vkorehov/LEAKCAM/BOM_LCSC.txt

LCSC order list, 2 board(s), generated from the schematic Descriptions; prices JLCPCB/LCSC parts API

qty   LCSC#       Basic/Ext value                        link                                               MPN  (designators)

2     C2757850    Extended  AHT20                        https://www.lcsc.com/product-detail/C2757850.html  AHT20  (U17)
2     C41368035   Extended  ai-m62-cbs(blifn4)           https://www.lcsc.com/product-detail/C41368035.html Ai-M62-CBS(BLIFN4)  (U11)
4     C28323      Basic     1uF 0805                     https://www.lcsc.com/product-detail/C28323.html    CL21B105KBFNNNE  (C97 C101)
108   C2903663    Extended  100n 0201                    https://www.lcsc.com/product-detail/C2903663.html  TCC0201X5R104K160ZT  (C10 C12 C13 C25 C26 C27 C28 C29 C30 C31 C37 C39 C40 C42 C43 C44 C45 C46 C47 C48 C49 C51 C52 C53 C54 C55 C56 C57 C58 C63 C65 C66 C67 C68 C69 C70 C71 C72 C73 C74 C75 C76 C77 C78 C79 C80 C81 C82 C84 C85 C93 C94 C100 CB2)
24    C307331     Basic     100n                         https://www.lcsc.com/product-detail/C307331.html   CL05B104KB54PNC  (C5 C6 C7 C8 C9 C23 C24 C32 C88 C92 C95 C109)
4     C1546       Basic     100pf                        https://www.lcsc.com/product-detail/C1546.html     0402CG101J500NT  (C21 C22)
4     C1547       Basic     12p                          https://www.lcsc.com/product-detail/C1547.html     0402CG120J500NT  (C35 C36)
10    C1554       Basic     20p                          https://www.lcsc.com/product-detail/C1554.html     0402CG200J500NT  (C33 C34 C98 C111 C112)
4     C16772      Basic     220n                         https://www.lcsc.com/product-detail/C16772.html    CL05B224KO5NNNC  (C103 C107)
6     C22466352   Promo     DSK24                        https://www.lcsc.com/product-detail/C22466352.html DSK24  (D2 D7 D8)
4     C22459552   Extended  05b20l22p                    https://www.lcsc.com/product-detail/C22459552.html 05B20L22P  (J4 J5)
4     C1848       Basic     1uF 50V 1206                 https://www.lcsc.com/product-detail/C1848.html     CL31B105KBHNNNE  (C1 C104)
4     C32346      Basic     Q13FC13500004                https://www.lcsc.com/product-detail/C32346.html    Q13FC13500004  (Y1 Y3)
8     C14709      Basic     BLM18PG121SN1D               https://www.lcsc.com/product-detail/C14709.html    BLM18PG121SN1D  (FB1 FB2 FB3 FB4)
10    C668312     Extended  DFE201612E-R47M=P2           https://www.lcsc.com/product-detail/C668312.html   DFE201612E-R47M=P2  (L1 L2 L3 L4 L5)
4     C703141     Extended  DFE252012F-100M=P2           https://www.lcsc.com/product-detail/C703141.html   DFE252012F-100M=P2  (L6 L7)
6     C2845237    Extended  TPS63802DLAR                 https://www.lcsc.com/product-detail/C2845237.html  TPS63802DLAR  (U5 U8 U10)
4     C2693497    Extended  TPS62823DLCR                 https://www.lcsc.com/product-detail/C2693497.html  TPS62823DLCR  (U6 U7)
30    C19702      Basic     10uF GRM188R61A106ME69D      https://www.lcsc.com/product-detail/C19702.html    CL10A106KP8NNNC  (C2 C3 C4 C11 C15 C16 C19 C50 C90 C96 C99 C102 C105 C106 CB1)
2     C15849      Basic     1uF 0603                     https://www.lcsc.com/product-detail/C15849.html    CL10A105KB8NNNC  (C86)
12    C59461      Basic     22uF GRM188R60J226MEA0J      https://www.lcsc.com/product-detail/C59461.html    CL10A226MQ8NRNC  (C14 C17 C18 C20 C87 C89)
2     C2286       Basic     KT-0603R                     https://www.lcsc.com/product-detail/C2286.html     KT-0603R  (D1)
2     C15127      Basic     AO3401A                      https://www.lcsc.com/product-detail/C15127.html    AO3401A  (Q1)
4     C20917      Basic     AO3400A                      https://www.lcsc.com/product-detail/C20917.html    AO3400A  (Q2 Q4)
6     C478118     Extended  PRTR5V0U2F,115               https://www.lcsc.com/product-detail/C478118.html   PRTR5V0U2F,115  (D3 D4 D5)
2     C22769      Extended  1.5R                         https://www.lcsc.com/product-detail/C22769.html    0603WAF150KT5E  (R68)
2     C23157      Extended  3R                           https://www.lcsc.com/product-detail/C23157.html    0603WAF300KT5E  (R66)
2     C2965580    Extended  XL7EL89CKI-111YLC-24M        https://www.lcsc.com/product-detail/C2965580.html  XL7EL89CKI-111YLC-24M  (Y2)
16    C19185834   Extended  jnj-ltji0112w120/35mil/845-8 https://www.lcsc.com/product-detail/C19185834.html JNJ-LTJI0112W120/35mil/845-860nm  (LED3 LED6 LED7 LED10 LED11 LED14 LED15 LED16)
6     C157932     Extended  S2B-PH-K-S(LF)(SN)           https://www.lcsc.com/product-detail/C157932.html   S2B-PH-K-S-GW  (S1 S2 S3)
2     C42414902   Extended  k230d                        https://www.lcsc.com/product-detail/C42414902.html K230D  (U3)
8     C25867      Basic     1.5k                         https://www.lcsc.com/product-detail/C25867.html    0402WGF1501TCE  (R5 R12 RD1 RD2)
40    C25741      Basic     100k                         https://www.lcsc.com/product-detail/C25741.html    0402WGF1003TCE  (R6 R8 R19 R20 R23 R26 R27 R28 R30 R32 R35 R38 R45 R49 R51 R53 R58 R60 R61 R76)
38    C25744      Basic     10k                          https://www.lcsc.com/product-detail/C25744.html    0402WGF1002TCE  (R2 R3 R10 R13 R16 R31 R34 R36 R39 R40 R41 R43 R44 R57 R64 R65 R67 R70 RBT1)
2     C25750      Promo     120k                         https://www.lcsc.com/product-detail/C25750.html    0402WGF1203TCE  (R29)
4     C26083      Basic     1M                           https://www.lcsc.com/product-detail/C26083.html    0402WGF1004TCE  (R71 R72)
2     C11702      Basic     1k                           https://www.lcsc.com/product-detail/C11702.html    0402WGF1001TCE  (R7)
4     C25087      Basic     200R                         https://www.lcsc.com/product-detail/C25087.html    0402WGF2000TCE  (R37 R62)
2     C25764      Basic     200k                         https://www.lcsc.com/product-detail/C25764.html    0402WGF2003TCE  (R59)
2     C25765      Basic     20k                          https://www.lcsc.com/product-detail/C25765.html    0402WGF2002TCE  (R69)
4     C25092      Basic     22R                          https://www.lcsc.com/product-detail/C25092.html    0402WGF220JTCE  (R42 R54)
10    C324768     Extended  240R                         https://www.lcsc.com/product-detail/C324768.html   RC-02K2400FT  (R33 R46 R47 R48 R52)
2     C49653548   Extended  30k                          https://www.lcsc.com/product-detail/C49653548.html GR0402F30KTAG00  (R63)
2     C25779      Basic     33k                          https://www.lcsc.com/product-detail/C25779.html    0402WGF3302TCE  (R25)
12    C25900      Basic     4.7k                         https://www.lcsc.com/product-detail/C25900.html    0402WGF4701TCE  (R14 R15 R17 R18 R73 R74)
14    C25792      Basic     47k                          https://www.lcsc.com/product-detail/C25792.html    0402WGF4702TCE  (R21 RB1 RB2 RB3 RB4 RB5 RB6)
8     C25905      Basic     5.1k                         https://www.lcsc.com/product-detail/C25905.html    0402WGF5101TCE  (R1 R4 R9 R11)
4     C49655223   Extended  511k                         https://www.lcsc.com/product-detail/C49655223.html GR0402F511KTAG00  (R22 R50)
2     C25794      Basic     51k                          https://www.lcsc.com/product-detail/C25794.html    0402WGF5102TCE  (R56)
4     C54920709   Extended  91k                          https://www.lcsc.com/product-detail/C54920709.html HRC0402F9102DNTO  (R24 R55)
2     C129319     Extended  BQ24072TRGTR                 https://www.lcsc.com/product-detail/C129319.html   BQ24072TRGTR  (U1)
4     C324075     Extended  TPS61161DRVR                 https://www.lcsc.com/product-detail/C324075.html   TPS61161DRVR  (U14 U15)
4     C165948     Extended  type-c-31-m-12               https://www.lcsc.com/product-detail/C165948.html   TYPE-C-31-M-12  (USBC1 USBC2)
16    C3646951    Extended  xl-hd3535uwc-a2              https://www.lcsc.com/product-detail/C3646951.html  XL-HD3535UWC-A2  (LED1 LED2 LED4 LED5 LED8 LED9 LED12 LED13)
2     C3035748    Extended  ch340x                       https://www.lcsc.com/product-detail/C3035748.html  CH340X  (U2)
2     C51928208   Extended  msm381acb026                 https://www.lcsc.com/product-detail/C51928208.html MSM381ACB026  (U13)
2     C17626844   Extended  w25n02kvzeir                 https://www.lcsc.com/product-detail/C17626844.html W25N02KVZEIR  (U16)

NO PART: ANT1 MIFI, B1_N TESTP, B1_P TESTP, CT1 NF, J1 Connector 2PIn, J2 Connector 2PIn, J3 Connector 2PIn, J6 Connector 2PIn, J7 Connector 2PIn, J8 Connector 2PIn, J9 Connector 2PIn, J10 Connector 2PIn, J11 Connector 2PIn, J12 Connector 2PIn, JB1 Connector 2PIn, JB2 Connector 2PIn, JT Connector 2PIn, PR1 CON6P

TOTAL 94.48 USD
