vkorehov/LEAKCAM/BOM_NEXTPCB.xlsx

Designator* | Quantity* | Manufacturer Part Number* | Manufacturer | Package/Footprint | Description | Procurement Type | Customer Note
U17 | 1 | AHT20 | Aosong (Guangzhou) Elec | SMD | -40℃~+120℃ 0%RH~100%RH 2.2V~5.5V 20bit 570uA I2C ±0.3℃ ±2%RH SMD Temperature and Humidity Sensor ROHS |  | LCSC C2757850, AHT20
U11 | 1 | Ai-M62-CBS(BLIFN4) | Ai-Thinker | SMD,12x12mm | -40℃~+85℃ -98dBm 2.97V~3.6V 22dBm 394mA 59mA BL616 UART、SDIO、SPI、I2C、GPIO、PWM、I2S、USB2.0 SMD,12x12mm WiFi Modules ROHS |  | LCSC C41368035, ai-m62-cbs(blifn4)
C97,C101 | 2 | CL21B105KBFNNNE | Samsung Electro-Mechanics | 0805 | 1uF 50V X7R ±10% 0805 Multilayer Ceramic Capacitors MLCC - SMD/SMT ROHS |  | LCSC C28323, 1uF 0805
C10,C12,C13,C25,C26,C27,C28,C29,C30,C31,C37,C39,C40,C42,C43,C44,C45,C46,C47,C48,C49,C51,C52,C53,C54,C55,C56,C57,C58,C63,C65,C66,C67,C68,C69,C70,C71,C72,C73,C74,C75,C76,C77,C78,C79,C80,C81,C82,C84,C85,C93,C94,C100,CB2 | 54 | TCC0201X5R104K160ZT | CCTC | 0201 | 100nF 16V X5R ±10% 0201 Multilayer Ceramic Capacitors MLCC - SMD/SMT ROHS |  | LCSC C2903663, 100n 0201
C5,C6,C7,C8,C9,C23,C24,C32,C88,C92,C95,C109 | 12 | CL05B104KB54PNC | Samsung Electro-Mechanics | 0402 | 100nF 50V X7R ±10% 0402 Multilayer Ceramic Capacitors MLCC - SMD/SMT ROHS |  | LCSC C307331, 100n
C21,C22 | 2 | 0402CG101J500NT | FH (Guangdong Fenghua Advanced Tech) | 0402 | 100pF 50V C0G ±5% 0402 Multilayer Ceramic Capacitors MLCC - SMD/SMT ROHS |  | LCSC C1546, 100pf
C35,C36 | 2 | 0402CG120J500NT | FH (Guangdong Fenghua Advanced Tech) | 0402 | 12pF 50V C0G ±5% 0402 Multilayer Ceramic Capacitors MLCC - SMD/SMT ROHS |  | LCSC C1547, 12p
C33,C34,C98,C111,C112 | 5 | 0402CG200J500NT | FH (Guangdong Fenghua Advanced Tech) | 0402 | 20pF 50V C0G ±5% 0402 Multilayer Ceramic Capacitors MLCC - SMD/SMT ROHS |  | LCSC C1554, 20p
C103,C107 | 2 | CL05B224KO5NNNC | Samsung Electro-Mechanics | 0402 | 16V 220nF X7R ±10% 0402 Multilayer Ceramic Capacitors MLCC - SMD/SMT ROHS |  | LCSC C16772, 220n
D2,D7,D8 | 3 | DSK24 | hongjiacheng | SOD-123FL | -55℃~+125℃ 2A 40V 500uA@40V 50A 550mV@2A Standalone SOD-123FL Schottky Diodes ROHS |  | LCSC C22466352, DSK24
J4,J5 | 2 | 05B20L22P | HanElectricity | SMD,P=0.5mm,Surface Mount，Right Angle | -25℃~+85℃ 0.3mm 0.5mm 22P 2mm 400mA 50V Bottom Contact Phosphor bronze Slide Lock Surface Mount, Right Angle Tin SMD,P=0 |  | LCSC C22459552, 05b20l22p
C1,C104 | 2 | CL31B105KBHNNNE | Samsung Electro-Mechanics | 1206 | 1uF 50V X7R ±10% 1206 Multilayer Ceramic Capacitors MLCC - SMD/SMT ROHS |  | LCSC C1848, 1uF 50V 1206
Y1,Y3 | 2 | Q13FC13500004 | Seiko Epson | SMD3215-2P | -40℃~+85℃ 12.5pF 32.768kHz 70kΩ Crystal Oscillator ±20ppm SMD3215-2P Crystals ROHS |  | LCSC C32346, Q13FC13500004
FB1,FB2,FB3,FB4 | 4 | BLM18PG121SN1D | Murata Electronics | 0603 | -55℃~+125℃ 1 120Ω@100MHz 2A 50mΩ ±25% 0603 Ferrite Beads ROHS |  | LCSC C14709, BLM18PG121SN1D
L1,L2,L3,L4,L5 | 5 | DFE201612E-R47M=P2 | Murata Electronics | 0806 | 26mΩ 4.5A 470nH 5.5A ±20% 0806 Power Inductors ROHS |  | LCSC C668312, DFE201612E-R47M=P2
L6,L7 | 2 | DFE252012F-100M=P2 | Murata Electronics | 1008 | 1.4A 10uH 400mΩ 950mA ±20% 1008 Power Inductors ROHS |  | LCSC C703141, DFE252012F-100M=P2
U5,U8,U10 | 3 | TPS63802DLAR | Texas Instruments | VSON-10(2x3) | -40℃~+125℃@(TJ) 1 1.3V~5.5V 1.4MHz、1.6MHz、2.1MHz 1.8V~5.2V 11uA 2A Adjustable Buck-Boost Buck-Boost Built-in Yes VSON-10 |  | LCSC C2845237, TPS63802DLAR
U6,U7 | 2 | TPS62823DLCR | Texas Instruments | VSON-8(1.5x2) | -40℃~+125℃@(TJ) 1 2.2MHz 2.4V~5.5V 3A 4uA 600mV~4V Adjustable Buck Built-in Overcurrent Protection、Light load efficient |  | LCSC C2693497, TPS62823DLCR
C2,C3,C4,C11,C15,C16,C19,C38,C41,C50,C59,C90,C96,C99,C102,C105,C106,CB1 | 18 | CL10A106KP8NNNC | Samsung Electro-Mechanics | 0603 | 10V 10uF X5R ±10% 0603 Multilayer Ceramic Capacitors MLCC - SMD/SMT ROHS |  | LCSC C19702, 10uF GRM188R61A106ME69D
C86 | 1 | CL10A105KB8NNNC | Samsung Electro-Mechanics | 0603 | 1uF 50V X5R ±10% 0603 Multilayer Ceramic Capacitors MLCC - SMD/SMT ROHS |  | LCSC C15849, 1uF 0603
C14,C17,C18,C20,C87,C89 | 6 | CL10A226MQ8NRNC | Samsung Electro-Mechanics | 0603 | 22uF 6.3V X5R ±20% 0603 Multilayer Ceramic Capacitors MLCC - SMD/SMT ROHS |  | LCSC C59461, 22uF GRM188R60J226MEA0J
D1 | 1 | KT-0603R | Hubei KENTO Elec | 0603 | -40℃~+85℃ 1.6mm x 0.8mm square LED 1.8V~2.4V 120° 20mA 300mcd 40mW 615nm~630nm 645nm Discrete Diode Red Water Clear 0603 |  | LCSC C2286, KT-0603R
Q1 | 1 | AO3401A | Alpha & Omega Semicon | SOT-23 | 1 P-Channel 14nC@10V 30V 47mΩ@10V、60mΩ@4.5V、85mΩ@2.5V 4A 55pF 645pF 80pF 900mV SOT-23 MOSFETs ROHS |  | LCSC C15127, AO3401A
Q2,Q4 | 2 | AO3400A | Alpha & Omega Semicon | SOT-23 | -55℃~+150℃ 1 N-channel 1.45V 1.4W 30V 48mΩ@2.5V 5.7A 50pF 630pF 75pF 7nC@10V N-Channel SOT-23 MOSFETs ROHS |  | LCSC C20917, AO3400A
D3,D4,D5 | 3 | PRTR5V0U2F,115 | Nexperia | XSON-6(1x1.5) | -40℃~+85℃ 100nA 1pF 2 5.5V 6V IEC 61000-4-2 TVS Unidirectional XSON-6(1x1.5) ESD and Surge Protection (TVS/ESD) ROHS |  | LCSC C478118, PRTR5V0U2F,115
R68 | 1 | 0603WAF150KT5E | UNI-ROYAL(Uniroyal Elec) | 0603 | -55℃~+155℃ 1.5Ω 100mW 75V Thick Film Resistor ±1% ±200ppm/℃ 0603 Chip Resistor - Surface Mount ROHS |  | LCSC C22769, 1.5R
R66 | 1 | 0603WAF300KT5E | UNI-ROYAL(Uniroyal Elec) | 0603 | -55℃~+155℃ 100mW 3Ω 75V Thick Film Resistor ±1% ±200ppm/℃ 0603 Chip Resistor - Surface Mount ROHS |  | LCSC C23157, 3R
Y2 | 1 | XL7EL89CKI-111YLC-24M | YXC Crystal Oscillators | SMD2016-4P | -40℃~+85℃ 100Ω 24MHz 8pF Crystal Oscillator ±10ppm ±20ppm SMD2016-4P Crystals ROHS |  | LCSC C2965580, XL7EL89CKI-111YLC-24M
LED3,LED6,LED7,LED10,LED11,LED14,LED15,LED16 | 8 | JNJ-LTJI0112W120/35mil/845-860nm | JNJ OPTOELECTRONICS | SMD3535-3P | -40℃~+100℃ 1.4V~2.1V、1.5V~2.3V 120° 1A 50nm 5V 75mW/sr@IF=350mA、140mW/sr@IF=1000mA 850nm SMD3535-3P Infrared LED Emitter |  | LCSC C19185834, jnj-ltji0112w120/35mil/845-860nm
U3 | 1 | K230D | Canaan | BGA-256 | BGA-256 Microcontrollers (MCU/MPU/SOC) ROHS |  | LCSC C42414902, k230d
R5,R12,RD1,RD2 | 4 | 0402WGF1501TCE | UNI-ROYAL(Uniroyal Elec) | 0402 | -55℃~+155℃ 1.5kΩ 50V 62.5mW Thick Film Resistor ±1% ±100ppm/℃ 0402 Chip Resistor - Surface Mount ROHS |  | LCSC C25867, 1.5k
R6,R8,R19,R20,R23,R26,R27,R28,R30,R32,R35,R38,R45,R49,R51,R53,R58,R60,R61,R76 | 20 | 0402WGF1003TCE | UNI-ROYAL(Uniroyal Elec) | 0402 | -55℃~+155℃ 100kΩ 50V 62.5mW Thick Film Resistor ±1% ±100ppm/℃ 0402 Chip Resistor - Surface Mount ROHS |  | LCSC C25741, 100k
R2,R3,R10,R13,R16,R31,R34,R36,R39,R40,R41,R43,R44,R57,R64,R65,R67,R70,RBT1 | 19 | 0402WGF1002TCE | UNI-ROYAL(Uniroyal Elec) | 0402 | -55℃~+155℃ 10kΩ 50V 62.5mW Thick Film Resistor ±1% ±100ppm/℃ 0402 Chip Resistor - Surface Mount ROHS |  | LCSC C25744, 10k
R29 | 1 | 0402WGF1203TCE | UNI-ROYAL(Uniroyal Elec) | 0402 | -55℃~+155℃ 120kΩ 50V 62.5mW Thick Film Resistor ±1% ±100ppm/℃ 0402 Chip Resistor - Surface Mount ROHS |  | LCSC C25750, 120k
R71,R72 | 2 | 0402WGF1004TCE | UNI-ROYAL(Uniroyal Elec) | 0402 | -55℃~+155℃ 1MΩ 50V 62.5mW Thick Film Resistor ±1% ±100ppm/℃ 0402 Chip Resistor - Surface Mount ROHS |  | LCSC C26083, 1M
R7 | 1 | 0402WGF1001TCE | UNI-ROYAL(Uniroyal Elec) | 0402 | -55℃~+155℃ 1kΩ 50V 62.5mW Thick Film Resistor ±1% ±100ppm/℃ 0402 Chip Resistor - Surface Mount ROHS |  | LCSC C11702, 1k
R37,R62 | 2 | 0402WGF2000TCE | UNI-ROYAL(Uniroyal Elec) | 0402 | -55℃~+155℃ 200Ω 50V 62.5mW Thick Film Resistor ±1% ±100ppm/℃ 0402 Chip Resistor - Surface Mount ROHS |  | LCSC C25087, 200R
R59 | 1 | 0402WGF2003TCE | UNI-ROYAL(Uniroyal Elec) | 0402 | -55℃~+155℃ 200kΩ 50V 62.5mW Thick Film Resistor ±1% ±100ppm/℃ 0402 Chip Resistor - Surface Mount ROHS |  | LCSC C25764, 200k
R69 | 1 | 0402WGF2002TCE | UNI-ROYAL(Uniroyal Elec) | 0402 | -55℃~+155℃ 20kΩ 50V 62.5mW Thick Film Resistor ±1% ±100ppm/℃ 0402 Chip Resistor - Surface Mount ROHS |  | LCSC C25765, 20k
R42,R54 | 2 | 0402WGF220JTCE | UNI-ROYAL(Uniroyal Elec) | 0402 | -55℃~+155℃ 22Ω 50V 62.5mW Thick Film Resistor ±1% ±100ppm/℃ 0402 Chip Resistor - Surface Mount ROHS |  | LCSC C25092, 22R
R33,R46,R47,R48,R52 | 5 | RC-02K2400FT | FH (Guangdong Fenghua Advanced Tech) | 0402 | -55℃~+155℃ 240Ω 50V 62.5mW Thick Film Resistor ±1% ±100ppm/℃ 0402 Chip Resistor - Surface Mount ROHS |  | LCSC C324768, 240R
R63 | 1 | GR0402F30KTAG00 | GiantOhm | 0402 | -55℃~+155℃ 30kΩ 50V 62.5mW Thick Film Resistor ±1% ±100ppm/℃ 0402 Chip Resistor - Surface Mount ROHS |  | LCSC C49653548, 30k
R25 | 1 | 0402WGF3302TCE | UNI-ROYAL(Uniroyal Elec) | 0402 | -55℃~+155℃ 33kΩ 50V 62.5mW Thick Film Resistor ±1% ±100ppm/℃ 0402 Chip Resistor - Surface Mount ROHS |  | LCSC C25779, 33k
R14,R15,R17,R18,R73,R74 | 6 | 0402WGF4701TCE | UNI-ROYAL(Uniroyal Elec) | 0402 | -55℃~+155℃ 4.7kΩ 50V 62.5mW Thick Film Resistor ±1% ±100ppm/℃ 0402 Chip Resistor - Surface Mount ROHS |  | LCSC C25900, 4.7k
R21,RB1,RB2,RB3,RB4,RB5,RB6 | 7 | 0402WGF4702TCE | UNI-ROYAL(Uniroyal Elec) | 0402 | -55℃~+155℃ 47kΩ 50V 62.5mW Thick Film Resistor ±1% ±100ppm/℃ 0402 Chip Resistor - Surface Mount ROHS |  | LCSC C25792, 47k
R1,R4,R9,R11 | 4 | 0402WGF5101TCE | UNI-ROYAL(Uniroyal Elec) | 0402 | -55℃~+155℃ 5.1kΩ 50V 62.5mW Thick Film Resistor ±1% ±100ppm/℃ 0402 Chip Resistor - Surface Mount ROHS |  | LCSC C25905, 5.1k
R22,R50 | 2 | GR0402F511KTAG00 | GiantOhm | 0402 | -55℃~+155℃ 50V 511kΩ 62.5mW Thick Film Resistor ±1% 0402 Chip Resistor - Surface Mount ROHS |  | LCSC C49655223, 511k
R56 | 1 | 0402WGF5102TCE | UNI-ROYAL(Uniroyal Elec) | 0402 | -55℃~+155℃ 50V 51kΩ 62.5mW Thick Film Resistor ±1% ±100ppm/℃ 0402 Chip Resistor - Surface Mount ROHS |  | LCSC C25794, 51k
R24,R55 | 2 | HRC0402F9102DNTO | HWA CHN | 0402 | -55℃~+155℃ 50V 62.5mW 91kΩ Thick Film Resistor ±1% ±100ppm/℃ 0402 Chip Resistor - Surface Mount ROHS |  | LCSC C54920709, 91k
U1 | 1 | BQ24072TRGTR | Texas Instruments | QFN-16-EP(3x3) | 0℃~+125℃ 1.5A 1.5mA 4.2V 4.35V~6.4V Charging IC Lithium Battery Support QFN-16-EP(3x3) Battery Management ROHS |  | LCSC C129319, BQ24072TRGTR
U14,U15 | 2 | TPS61161DRVR | Texas Instruments | WSON-6-EP(2x2) | -40℃~+85℃ 1 2% 2.7V~18V 38V 600kHz Boost Built-in DC-DC Over Voltage Protection、Over-Temperature Protection (OTP) PWM WS |  | LCSC C324075, TPS61161DRVR
USBC1,USBC2 | 2 | TYPE-C-31-M-12 | Korean Hroparts Elec | SMD | -30℃~+80℃ 1 10,000 cycles 16P 20V 5A 7.35mm Female Surface Mount, Right Angle Type-C SMD USB Connectors ROHS |  | LCSC C165948, type-c-31-m-12
LED1,LED2,LED4,LED5,LED8,LED9,LED12,LED13 | 8 | XL-HD3535UWC-A2 | XINGLIGHT | SMD3535-3P | -40℃~+85℃ 130° 1W 2.8V~3.6V 350mA 5500K~7000K Discrete Diode Top-mount Water Clear White SMD3535-3P LED Indication - Dis |  | LCSC C3646951, xl-hd3535uwc-a2
U2 | 1 | CH340X | WCH(Jiangsu Qin Heng) | MSOP-10 | -20℃~+70℃ 2Mbps 3.3V、5V USB 2.0 USB to serial、USB to Parallel MSOP-10 USB Converters ROHS |  | LCSC C3035748, ch340x
U13 | 1 | MSM381ACB026 | MEMS | LGA-3(1.9x2.8) | -38dB 0.9mm 1.85mm 170Ω 175uA 2.75mm 3.6V 64dB Analog output Omnidirectional Omnidirectional pickup LGA-3(1.9x2.8) MEMS |  | LCSC C51928208, msm381acb026
U16 | 1 | W25N02KVZEIR | Winbond Elec | WSON-8(6x8) | -40℃~+85℃ 10 years 104MHz 10uA 2.7V~3.6V 25ns 2Gbit 2ms 60,000 Cycles 700us Read buffer function、Software reset function |  | LCSC C17626844, w25n02kvzeir
