vkorehov/LEAKCAM/BOM_LCSC.xlsx

Designators | Qty/board | Needed (2 boards) | Value | Footprint | LCSC # | Chosen MPN | Manufacturer | Package | Basic/Ext | Stock | MOQ | Order qty | Unit USD | Total USD | LCSC link | Description
U17 | 1 | 2 | AHT20 | AHT30 | C2757850 | AHT20 | Aosong (Guangzhou) Elec | SMD | Extended | 39761 | 1 | 2 | 0.765 | 1.53 | https://www.lcsc.com/product-detail/C2757850.html | -40℃~+120℃ 0%RH~100%RH 2.2V~5.5V 20bit 570uA I2C ±0.3℃ ±2%RH SMD Temperature and Humidity Sensor ROHS
U11 | 1 | 2 | ai-m62-cbs(blifn4) | AI-M62-CBS | C41368035 | Ai-M62-CBS(BLIFN4) | Ai-Thinker | SMD,12x12mm | Extended | 216 | 1 | 2 | 2.2339 | 4.4678 | https://www.lcsc.com/product-detail/C41368035.html | -40℃~+85℃ -98dBm 2.97V~3.6V 22dBm 394mA 59mA BL616 UART、SDIO、SPI、I2C、GPIO、PWM、I2S、USB2.0 SMD,12x12mm WiFi Modules ROHS
C97 C101 | 2 | 4 | 1uF 0805 | CAPC2013X145X50NL20T20 | C28323 | CL21B105KBFNNNE | Samsung Electro-Mechanics | 0805 | Basic | 2506628 | 1 | 4 | 0.0384 | 0.1536 | https://www.lcsc.com/product-detail/C28323.html | 1uF 50V X7R ±10% 0805 Multilayer Ceramic Capacitors MLCC - SMD/SMT ROHS
C10 C12 C13 C25 C26 C27 C28 C29 C30 C31 C37 C39 C40 C42 C43 C44 C45 C46 C47 C48 C49 C51 C52 C53 C54 C55 C56 C57 C58 C63 C65 C66 C67 C68 C69 C70 C71 C72 C73 C74 C75 C76 C77 C78 C79 C80 C81 C82 C84 C85 C93 C94 C100 CB2 | 54 | 108 | 100n 0201 | CAP_0201 | C2903663 | TCC0201X5R104K160ZT | CCTC | 0201 | Extended | 175546 | 1 | 108 | 0.0021 | 0.2268 | https://www.lcsc.com/product-detail/C2903663.html | 100nF 16V X5R ±10% 0201 Multilayer Ceramic Capacitors MLCC - SMD/SMT ROHS
C5 C6 C7 C8 C9 C23 C24 C32 C88 C92 C95 C109 | 12 | 24 | 100n | CAP_0402 | C307331 | CL05B104KB54PNC | Samsung Electro-Mechanics | 0402 | Basic | 11684241 | 1 | 24 | 0.0087 | 0.2088 | https://www.lcsc.com/product-detail/C307331.html | 100nF 50V X7R ±10% 0402 Multilayer Ceramic Capacitors MLCC - SMD/SMT ROHS
C21 C22 | 2 | 4 | 100pf | CAP_0402 | C1546 | 0402CG101J500NT | FH (Guangdong Fenghua Advanced Tech) | 0402 | Basic | 3484695 | 1 | 4 | 0.004 | 0.016 | https://www.lcsc.com/product-detail/C1546.html | 100pF 50V C0G ±5% 0402 Multilayer Ceramic Capacitors MLCC - SMD/SMT ROHS
C35 C36 | 2 | 4 | 12p | CAP_0402 | C1547 | 0402CG120J500NT | FH (Guangdong Fenghua Advanced Tech) | 0402 | Basic | 2087450 | 1 | 4 | 0.0054 | 0.0216 | https://www.lcsc.com/product-detail/C1547.html | 12pF 50V C0G ±5% 0402 Multilayer Ceramic Capacitors MLCC - SMD/SMT ROHS
C33 C34 C98 C111 C112 | 5 | 10 | 20p | CAP_0402 | C1554 | 0402CG200J500NT | FH (Guangdong Fenghua Advanced Tech) | 0402 | Basic | 715431 | 1 | 10 | 0.007 | 0.07 | https://www.lcsc.com/product-detail/C1554.html | 20pF 50V C0G ±5% 0402 Multilayer Ceramic Capacitors MLCC - SMD/SMT ROHS
C103 C107 | 2 | 4 | 220n | CAP_0402 | C16772 | CL05B224KO5NNNC | Samsung Electro-Mechanics | 0402 | Basic | 2407623 | 1 | 4 | 0.0049 | 0.0196 | https://www.lcsc.com/product-detail/C16772.html | 16V 220nF X7R ±10% 0402 Multilayer Ceramic Capacitors MLCC - SMD/SMT ROHS
D2 D7 D8 | 3 | 6 | DSK24 | DSK24 | C22466352 | DSK24 | hongjiacheng | SOD-123FL | Promo | 2663079 | 1 | 6 | 0.0246 | 0.1476 | https://www.lcsc.com/product-detail/C22466352.html | -55℃~+125℃ 2A 40V 500uA@40V 50A 550mV@2A Standalone SOD-123FL Schottky Diodes ROHS
J4 J5 | 2 | 4 | 05b20l22p | FLEX_CON_22P | C22459552 | 05B20L22P | HanElectricity | SMD,P=0.5mm,Surface Mount，Right Angle | Extended | 2004 | 1 | 4 | 0.0697 | 0.2788 | https://www.lcsc.com/product-detail/C22459552.html | -25℃~+85℃ 0.3mm 0.5mm 22P 2mm 400mA 50V Bottom Contact Phosphor bronze Slide Lock Surface Mount, Right Angle Tin SMD,P=0
C1 C104 | 2 | 4 | 1uF 50V 1206 | FP-1206-L_3_2_0_2-W_1_6_0-IPC_B | C1848 | CL31B105KBHNNNE | Samsung Electro-Mechanics | 1206 | Basic | 636429 | 1 | 4 | 0.0468 | 0.1872 | https://www.lcsc.com/product-detail/C1848.html | 1uF 50V X7R ±10% 1206 Multilayer Ceramic Capacitors MLCC - SMD/SMT ROHS
Y1 Y3 | 2 | 4 | Q13FC13500004 | FP-ABS07-MFG | C32346 | Q13FC13500004 | Seiko Epson | SMD3215-2P | Basic | 500802 | 1 | 4 | 0.1652 | 0.6608 | https://www.lcsc.com/product-detail/C32346.html | -40℃~+85℃ 12.5pF 32.768kHz 70kΩ Crystal Oscillator ±20ppm SMD3215-2P Crystals ROHS
FB1 FB2 FB3 FB4 | 4 | 8 | BLM18PG121SN1D | FP-BLM18-0_15-t0_8-IPC_B | C14709 | BLM18PG121SN1D | Murata Electronics | 0603 | Basic | 2119409 | 1 | 8 | 0.014 | 0.112 | https://www.lcsc.com/product-detail/C14709.html | -55℃~+125℃ 1 120Ω@100MHz 2A 50mΩ ±25% 0603 Ferrite Beads ROHS
L1 L2 L3 L4 L5 | 5 | 10 | DFE201612E-R47M=P2 | FP-DFE201612C-IPC_C | C668312 | DFE201612E-R47M=P2 | Murata Electronics | 0806 | Extended | 8059 | 1 | 10 | 0.1712 | 1.712 | https://www.lcsc.com/product-detail/C668312.html | 26mΩ 4.5A 470nH 5.5A ±20% 0806 Power Inductors ROHS
L6 L7 | 2 | 4 | DFE252012F-100M=P2 | FP-DFE252012C-IPC_B | C703141 | DFE252012F-100M=P2 | Murata Electronics | 1008 | Extended | 16344 | 1 | 4 | 0.1538 | 0.6152 | https://www.lcsc.com/product-detail/C703141.html | 1.4A 10uH 400mΩ 950mA ±20% 1008 Power Inductors ROHS
U5 U8 U10 | 3 | 6 | TPS63802DLAR | FP-DLA0010A-MFG | C2845237 | TPS63802DLAR | Texas Instruments | VSON-10(2x3) | Extended | 18115 | 1 | 6 | 0.9778 | 5.8668 | https://www.lcsc.com/product-detail/C2845237.html | -40℃~+125℃@(TJ) 1 1.3V~5.5V 1.4MHz、1.6MHz、2.1MHz 1.8V~5.2V 11uA 2A Adjustable Buck-Boost Buck-Boost Built-in Yes VSON-10
U6 U7 | 2 | 4 | TPS62823DLCR | FP-DLC0008A-MFG | C2693497 | TPS62823DLCR | Texas Instruments | VSON-8(1.5x2) | Extended | 8244 | 1 | 4 | 1.0841 | 4.3364 | https://www.lcsc.com/product-detail/C2693497.html | -40℃~+125℃@(TJ) 1 2.2MHz 2.4V~5.5V 3A 4uA 600mV~4V Adjustable Buck Built-in Overcurrent Protection、Light load efficient
C2 C3 C4 C11 C15 C16 C19 C50 C90 C96 C99 C102 C105 C106 CB1 | 15 | 30 | 10uF GRM188R61A106ME69D | FP-GRM188-0_15-MFG | C19702 | CL10A106KP8NNNC | Samsung Electro-Mechanics | 0603 | Basic | 11251848 | 1 | 30 | 0.0307 | 0.921 | https://www.lcsc.com/product-detail/C19702.html | 10V 10uF X5R ±10% 0603 Multilayer Ceramic Capacitors MLCC - SMD/SMT ROHS
C86 | 1 | 2 | 1uF 0603 | FP-GRM188-0_15-MFG | C15849 | CL10A105KB8NNNC | Samsung Electro-Mechanics | 0603 | Basic | 6248852 | 1 | 2 | 0.0147 | 0.0294 | https://www.lcsc.com/product-detail/C15849.html | 1uF 50V X5R ±10% 0603 Multilayer Ceramic Capacitors MLCC - SMD/SMT ROHS
C14 C17 C18 C20 C87 C89 | 6 | 12 | 22uF GRM188R60J226MEA0J | FP-GRM188-0_2-IPC_C | C59461 | CL10A226MQ8NRNC | Samsung Electro-Mechanics | 0603 | Basic | 8373464 | 1 | 12 | 0.0299 | 0.3588 | https://www.lcsc.com/product-detail/C59461.html | 22uF 6.3V X5R ±20% 0603 Multilayer Ceramic Capacitors MLCC - SMD/SMT ROHS
D1 | 1 | 2 | KT-0603R | FP-SML-LX0603IW-TR-MFG | C2286 | KT-0603R | Hubei KENTO Elec | 0603 | Basic | 4013302 | 1 | 2 | 0.0073 | 0.0146 | https://www.lcsc.com/product-detail/C2286.html | -40℃~+85℃ 1.6mm x 0.8mm square LED 1.8V~2.4V 120° 20mA 300mcd 40mW 615nm~630nm 645nm Discrete Diode Red Water Clear 0603
Q1 | 1 | 2 | AO3401A | FP-SOT23-IPC_B | C15127 | AO3401A | Alpha & Omega Semicon | SOT-23 | Basic | 783049 | 1 | 2 | 0.0906 | 0.1812 | https://www.lcsc.com/product-detail/C15127.html | 1 P-Channel 14nC@10V 30V 47mΩ@10V、60mΩ@4.5V、85mΩ@2.5V 4A 55pF 645pF 80pF 900mV SOT-23 MOSFETs ROHS
Q2 Q4 | 2 | 4 | AO3400A | FP-SOT23-MFG | C20917 | AO3400A | Alpha & Omega Semicon | SOT-23 | Basic | 1073957 | 1 | 4 | 0.0814 | 0.3256 | https://www.lcsc.com/product-detail/C20917.html | -55℃~+150℃ 1 N-channel 1.45V 1.4W 30V 48mΩ@2.5V 5.7A 50pF 630pF 75pF 7nC@10V N-Channel SOT-23 MOSFETs ROHS
D3 D4 D5 | 3 | 6 | PRTR5V0U2F,115 | FP-SOT886-MFG | C478118 | PRTR5V0U2F,115 | Nexperia | XSON-6(1x1.5) | Extended | 2425 | 1 | 6 | 0.4021 | 2.4126 | https://www.lcsc.com/product-detail/C478118.html | -40℃~+85℃ 100nA 1pF 2 5.5V 6V IEC 61000-4-2 TVS Unidirectional XSON-6(1x1.5) ESD and Surge Protection (TVS/ESD) ROHS
R68 | 1 | 2 | 1.5R | FP-SR0603-MFG | C22769 | 0603WAF150KT5E | UNI-ROYAL(Uniroyal Elec) | 0603 | Extended | 112055 | 1 | 2 | 0.0043 | 0.0086 | https://www.lcsc.com/product-detail/C22769.html | -55℃~+155℃ 1.5Ω 100mW 75V Thick Film Resistor ±1% ±200ppm/℃ 0603 Chip Resistor - Surface Mount ROHS
R66 | 1 | 2 | 3R | FP-SR0603-MFG | C23157 | 0603WAF300KT5E | UNI-ROYAL(Uniroyal Elec) | 0603 | Extended | 43619 | 1 | 2 | 0.0039 | 0.0078 | https://www.lcsc.com/product-detail/C23157.html | -55℃~+155℃ 100mW 3Ω 75V Thick Film Resistor ±1% ±200ppm/℃ 0603 Chip Resistor - Surface Mount ROHS
Y2 | 1 | 2 | XL7EL89CKI-111YLC-24M | FP-XRCGB_F_N-MFG | C2965580 | XL7EL89CKI-111YLC-24M | YXC Crystal Oscillators | SMD2016-4P | Extended | 33690 | 1 | 2 | 0.0783 | 0.1566 | https://www.lcsc.com/product-detail/C2965580.html | -40℃~+85℃ 100Ω 24MHz 8pF Crystal Oscillator ±10ppm ±20ppm SMD2016-4P Crystals ROHS
LED3 LED6 LED7 LED10 LED11 LED14 LED15 LED16 | 8 | 16 | jnj-ltji0112w120/35mil/845-860nm | JNJ-LTJI0112W120 | C19185834 | JNJ-LTJI0112W120/35mil/845-860nm | JNJ OPTOELECTRONICS | SMD3535-3P | Extended | 438 | 1 | 16 | 0.3379 | 5.4064 | https://www.lcsc.com/product-detail/C19185834.html | -40℃~+100℃ 1.4V~2.1V、1.5V~2.3V 120° 1A 50nm 5V 75mW/sr@IF=350mA、140mW/sr@IF=1000mA 850nm SMD3535-3P Infrared LED Emitter
S1 S2 S3 | 3 | 6 | S2B-PH-K-S(LF)(SN) | JST-S2B-PH-K-S_V | C157932 | S2B-PH-K-S-GW | JST | Push-Pull,P=2mm | Extended | 14960 | 1 | 6 | 0.2122 | 1.2732 | https://www.lcsc.com/product-detail/C157932.html | -25℃~+85℃ 1 100V 1x2P 2 2A 2P 2mm 4.8mm 5.9mm 7.6mm Brass K Pin PA66 PH Right Angle Tin UL94V-0 White 弯插,P=2mm Wire To B
U3 | 1 | 2 | k230d | K230D | C42414902 | K230D | Canaan | BGA-256 | Extended | 340 | 1 | 2 | 13.2782 | 26.5564 | https://www.lcsc.com/product-detail/C42414902.html | BGA-256 Microcontrollers (MCU/MPU/SOC) ROHS
R5 R12 RD1 RD2 | 4 | 8 | 1.5k | RES_0402 | C25867 | 0402WGF1501TCE | UNI-ROYAL(Uniroyal Elec) | 0402 | Basic | 2186424 | 1 | 8 | 0.0028 | 0.0224 | https://www.lcsc.com/product-detail/C25867.html | -55℃~+155℃ 1.5kΩ 50V 62.5mW Thick Film Resistor ±1% ±100ppm/℃ 0402 Chip Resistor - Surface Mount ROHS
R6 R8 R19 R20 R23 R26 R27 R28 R30 R32 R35 R38 R45 R49 R51 R53 R58 R60 R61 R76 | 20 | 40 | 100k | RES_0402 | C25741 | 0402WGF1003TCE | UNI-ROYAL(Uniroyal Elec) | 0402 | Basic | 8980361 | 1 | 40 | 0.0024 | 0.096 | https://www.lcsc.com/product-detail/C25741.html | -55℃~+155℃ 100kΩ 50V 62.5mW Thick Film Resistor ±1% ±100ppm/℃ 0402 Chip Resistor - Surface Mount ROHS
R2 R3 R10 R13 R16 R31 R34 R36 R39 R40 R41 R43 R44 R57 R64 R65 R67 R70 RBT1 | 19 | 38 | 10k | RES_0402 | C25744 | 0402WGF1002TCE | UNI-ROYAL(Uniroyal Elec) | 0402 | Basic | 23769742 | 1 | 38 | 0.0033 | 0.1254 | https://www.lcsc.com/product-detail/C25744.html | -55℃~+155℃ 10kΩ 50V 62.5mW Thick Film Resistor ±1% ±100ppm/℃ 0402 Chip Resistor - Surface Mount ROHS
R29 | 1 | 2 | 120k | RES_0402 | C25750 | 0402WGF1203TCE | UNI-ROYAL(Uniroyal Elec) | 0402 | Promo | 708170 | 1 | 2 | 0.0011 | 0.0022 | https://www.lcsc.com/product-detail/C25750.html | -55℃~+155℃ 120kΩ 50V 62.5mW Thick Film Resistor ±1% ±100ppm/℃ 0402 Chip Resistor - Surface Mount ROHS
R71 R72 | 2 | 4 | 1M | RES_0402 | C26083 | 0402WGF1004TCE | UNI-ROYAL(Uniroyal Elec) | 0402 | Basic | 2682285 | 1 | 4 | 0.0025 | 0.01 | https://www.lcsc.com/product-detail/C26083.html | -55℃~+155℃ 1MΩ 50V 62.5mW Thick Film Resistor ±1% ±100ppm/℃ 0402 Chip Resistor - Surface Mount ROHS
R7 | 1 | 2 | 1k | RES_0402 | C11702 | 0402WGF1001TCE | UNI-ROYAL(Uniroyal Elec) | 0402 | Basic | 8695277 | 1 | 2 | 0.0018 | 0.0036 | https://www.lcsc.com/product-detail/C11702.html | -55℃~+155℃ 1kΩ 50V 62.5mW Thick Film Resistor ±1% ±100ppm/℃ 0402 Chip Resistor - Surface Mount ROHS
R37 R62 | 2 | 4 | 200R | RES_0402 | C25087 | 0402WGF2000TCE | UNI-ROYAL(Uniroyal Elec) | 0402 | Basic | 2672337 | 1 | 4 | 0.0028 | 0.0112 | https://www.lcsc.com/product-detail/C25087.html | -55℃~+155℃ 200Ω 50V 62.5mW Thick Film Resistor ±1% ±100ppm/℃ 0402 Chip Resistor - Surface Mount ROHS
R59 | 1 | 2 | 200k | RES_0402 | C25764 | 0402WGF2003TCE | UNI-ROYAL(Uniroyal Elec) | 0402 | Basic | 2454057 | 1 | 2 | 0.0017 | 0.0034 | https://www.lcsc.com/product-detail/C25764.html | -55℃~+155℃ 200kΩ 50V 62.5mW Thick Film Resistor ±1% ±100ppm/℃ 0402 Chip Resistor - Surface Mount ROHS
R69 | 1 | 2 | 20k | RES_0402 | C25765 | 0402WGF2002TCE | UNI-ROYAL(Uniroyal Elec) | 0402 | Basic | 1295158 | 1 | 2 | 0.0022 | 0.0044 | https://www.lcsc.com/product-detail/C25765.html | -55℃~+155℃ 20kΩ 50V 62.5mW Thick Film Resistor ±1% ±100ppm/℃ 0402 Chip Resistor - Surface Mount ROHS
R42 R54 | 2 | 4 | 22R | RES_0402 | C25092 | 0402WGF220JTCE | UNI-ROYAL(Uniroyal Elec) | 0402 | Basic | 4130780 | 1 | 4 | 0.0026 | 0.0104 | https://www.lcsc.com/product-detail/C25092.html | -55℃~+155℃ 22Ω 50V 62.5mW Thick Film Resistor ±1% ±100ppm/℃ 0402 Chip Resistor - Surface Mount ROHS
R33 R46 R47 R48 R52 | 5 | 10 | 240R | RES_0402 | C324768 | RC-02K2400FT | FH (Guangdong Fenghua Advanced Tech) | 0402 | Extended | 296076 | 1 | 10 | 0.0013 | 0.013 | https://www.lcsc.com/product-detail/C324768.html | -55℃~+155℃ 240Ω 50V 62.5mW Thick Film Resistor ±1% ±100ppm/℃ 0402 Chip Resistor - Surface Mount ROHS
R63 | 1 | 2 | 30k | RES_0402 | C49653548 | GR0402F30KTAG00 | GiantOhm | 0402 | Extended | 7960 | 1 | 2 | 0.0008 | 0.0016 | https://www.lcsc.com/product-detail/C49653548.html | -55℃~+155℃ 30kΩ 50V 62.5mW Thick Film Resistor ±1% ±100ppm/℃ 0402 Chip Resistor - Surface Mount ROHS
R25 | 1 | 2 | 33k | RES_0402 | C25779 | 0402WGF3302TCE | UNI-ROYAL(Uniroyal Elec) | 0402 | Basic | 1315050 | 1 | 2 | 0.0056 | 0.0112 | https://www.lcsc.com/product-detail/C25779.html | -55℃~+155℃ 33kΩ 50V 62.5mW Thick Film Resistor ±1% ±100ppm/℃ 0402 Chip Resistor - Surface Mount ROHS
R14 R15 R17 R18 R73 R74 | 6 | 12 | 4.7k | RES_0402 | C25900 | 0402WGF4701TCE | UNI-ROYAL(Uniroyal Elec) | 0402 | Basic | 16169345 | 1 | 12 | 0.0026 | 0.0312 | https://www.lcsc.com/product-detail/C25900.html | -55℃~+155℃ 4.7kΩ 50V 62.5mW Thick Film Resistor ±1% ±100ppm/℃ 0402 Chip Resistor - Surface Mount ROHS
R21 RB1 RB2 RB3 RB4 RB5 RB6 | 7 | 14 | 47k | RES_0402 | C25792 | 0402WGF4702TCE | UNI-ROYAL(Uniroyal Elec) | 0402 | Basic | 5812552 | 1 | 14 | 0.0025 | 0.035 | https://www.lcsc.com/product-detail/C25792.html | -55℃~+155℃ 47kΩ 50V 62.5mW Thick Film Resistor ±1% ±100ppm/℃ 0402 Chip Resistor - Surface Mount ROHS
R1 R4 R9 R11 | 4 | 8 | 5.1k | RES_0402 | C25905 | 0402WGF5101TCE | UNI-ROYAL(Uniroyal Elec) | 0402 | Basic | 6490134 | 1 | 8 | 0.0023 | 0.0184 | https://www.lcsc.com/product-detail/C25905.html | -55℃~+155℃ 5.1kΩ 50V 62.5mW Thick Film Resistor ±1% ±100ppm/℃ 0402 Chip Resistor - Surface Mount ROHS
R22 R50 | 2 | 4 | 511k | RES_0402 | C49655223 | GR0402F511KTAG00 | GiantOhm | 0402 | Extended | 7360 | 1 | 4 | 0.0008 | 0.0032 | https://www.lcsc.com/product-detail/C49655223.html | -55℃~+155℃ 50V 511kΩ 62.5mW Thick Film Resistor ±1% 0402 Chip Resistor - Surface Mount ROHS
R56 | 1 | 2 | 51k | RES_0402 | C25794 | 0402WGF5102TCE | UNI-ROYAL(Uniroyal Elec) | 0402 | Basic | 2002312 | 1 | 2 | 0.0018 | 0.0036 | https://www.lcsc.com/product-detail/C25794.html | -55℃~+155℃ 50V 51kΩ 62.5mW Thick Film Resistor ±1% ±100ppm/℃ 0402 Chip Resistor - Surface Mount ROHS
R24 R55 | 2 | 4 | 91k | RES_0402 | C54920709 | HRC0402F9102DNTO | HWA CHN | 0402 | Extended | 130518 | 1 | 4 | 0.0007 | 0.0028 | https://www.lcsc.com/product-detail/C54920709.html | -55℃~+155℃ 50V 62.5mW 91kΩ Thick Film Resistor ±1% ±100ppm/℃ 0402 Chip Resistor - Surface Mount ROHS
U1 | 1 | 2 | BQ24072TRGTR | RGT0016C_V | C129319 | BQ24072TRGTR | Texas Instruments | QFN-16-EP(3x3) | Extended | 356 | 1 | 2 | 2.1635 | 4.327 | https://www.lcsc.com/product-detail/C129319.html | 0℃~+125℃ 1.5A 1.5mA 4.2V 4.35V~6.4V Charging IC Lithium Battery Support QFN-16-EP(3x3) Battery Management ROHS
U14 U15 | 2 | 4 | TPS61161DRVR | TPS61160ADRVT | C324075 | TPS61161DRVR | Texas Instruments | WSON-6-EP(2x2) | Extended | 2074 | 1 | 4 | 0.4099 | 1.6396 | https://www.lcsc.com/product-detail/C324075.html | -40℃~+85℃ 1 2% 2.7V~18V 38V 600kHz Boost Built-in DC-DC Over Voltage Protection、Over-Temperature Protection (OTP) PWM WS
USBC1 USBC2 | 2 | 4 | type-c-31-m-12 | TYPE-C-31-M-12 | C165948 | TYPE-C-31-M-12 | Korean Hroparts Elec | SMD | Extended | 89623 | 1 | 4 | 0.1787 | 0.7148 | https://www.lcsc.com/product-detail/C165948.html | -30℃~+80℃ 1 10,000 cycles 16P 20V 5A 7.35mm Female Surface Mount, Right Angle Type-C SMD USB Connectors ROHS
LED1 LED2 LED4 LED5 LED8 LED9 LED12 LED13 | 8 | 16 | xl-hd3535uwc-a2 | XL-HD3535UWC-A2 | C3646951 | XL-HD3535UWC-A2 | XINGLIGHT | SMD3535-3P | Extended | 19504 | 1 | 16 | 0.3073 | 4.9168 | https://www.lcsc.com/product-detail/C3646951.html | -40℃~+85℃ 130° 1W 2.8V~3.6V 350mA 5500K~7000K Discrete Diode Top-mount Water Clear White SMD3535-3P LED Indication - Dis
U2 | 1 | 2 | ch340x | ch340x | C3035748 | CH340X | WCH(Jiangsu Qin Heng) | MSOP-10 | Extended | 16766 | 1 | 2 | 0.6618 | 1.3236 | https://www.lcsc.com/product-detail/C3035748.html | -20℃~+70℃ 2Mbps 3.3V、5V USB 2.0 USB to serial、USB to Parallel MSOP-10 USB Converters ROHS
U13 | 1 | 2 | msm381acb026 | mems | C51928208 | MSM381ACB026 | MEMS | LGA-3(1.9x2.8) | Extended | 6244 | 1 | 2 | 0.302 | 0.604 | https://www.lcsc.com/product-detail/C51928208.html | -38dB 0.9mm 1.85mm 170Ω 175uA 2.75mm 3.6V 64dB Analog output Omnidirectional Omnidirectional pickup LGA-3(1.9x2.8) MEMS
U16 | 1 | 2 | w25n02kvzeir | w25n02 | C17626844 | W25N02KVZEIR | Winbond Elec | WSON-8(6x8) | Extended | 7614 | 1 | 2 | 11.1319 | 22.2638 | https://www.lcsc.com/product-detail/C17626844.html | -40℃~+85℃ 10 years 104MHz 10uA 2.7V~3.6V 25ns 2Gbit 2ms 60,000 Cycles 700us Read buffer function、Software reset function
B1_N | 1 | 2 | TESTP |  |  | NO PART
B1_P | 1 | 2 | TESTP |  |  | NO PART
J1 | 1 | 2 | Connector 2PIn |  |  | NO PART
J2 | 1 | 2 | Connector 2PIn |  |  | NO PART
J3 | 1 | 2 | Connector 2PIn |  |  | NO PART
J7 | 1 | 2 | Connector 2PIn |  |  | NO PART
J9 | 1 | 2 | Connector 2PIn |  |  | NO PART
J11 | 1 | 2 | Connector 2PIn |  |  | NO PART
J6 | 1 | 2 | Connector 2PIn |  |  | NO PART
J8 | 1 | 2 | Connector 2PIn |  |  | NO PART
J10 | 1 | 2 | Connector 2PIn |  |  | NO PART
J12 | 1 | 2 | Connector 2PIn |  |  | NO PART
JB1 | 1 | 2 | Connector 2PIn |  |  | NO PART
JB2 | 1 | 2 | Connector 2PIn |  |  | NO PART
JT | 1 | 2 | Connector 2PIn |  |  | NO PART
ANT1 | 1 | 2 | MIFI |  |  | NO PART
CT1 | 1 | 2 | NF |  |  | NO PART
PR1 | 1 | 2 | CON6P |  |  | NO PART
TOTAL |  |  |  |  |  |  |  |  |  |  |  |  |  | 94.48
