vkorehov/LEAKCAM/LEAKCAM.xlsx

Comment | Description | Designator | Footprint | LibRef | Quantity
TESTP |  | B1_N, B1_P | TESTP | TESTP | 2
1uF 1206 50V | Automotive Ceramic Capacitor, 1206, 1uF, 5%, X7R, 15%, 50V | C1 | FP-1206-L_3_2_0_2-W_1_6_0-IPC_B | CMP-04427-010925-1 | 1
10uF GRM188R61A106ME69D | Chip Multilayer Ceramic Capacitors for General Purpose, 0603, 10uF, X5R, 15%, 20%, 10V | C2, C3, C11, C15, C16, C19, C50, C90, C99, C102, C105, C106 | FP-GRM188-0_15-MFG | CMP-06035-003612-1 | 12
100n | CAP CER 0.1UF 50V X7R 0402 | C5, C6, C7, C8, C23, C24, C32, C88, C92, C95, C109, C110 | CAP_0402 | 11868f565c42a9108669ba33697ecf6 | 12
100n 0201 |  | C10, C12, C13, C25, C26, C27, C28, C29, C30, C31, C37, C39, C40, C42, C43, C44, C45, C46, C47, C48, C49, C51, C52, C53, C54, C55, C56, C57, C58, C63, C65, C66, C67, C68, C69, C70, C71, C72, C73, C74, C75, C76, C77, C78, C79, C80, C81, C82, C84, C85, C93, C94, C100 | CAP_0201 | CMP-03422-001116-1 | 53
22uF GRM188R60J226MEA0J | Chip Multilayer Ceramic Capacitors for General Purpose, 0603, 22uF, X5R, 15%, 20%, 6.3V | C14, C17, C18, C20, C87, C89 | FP-GRM188-0_2-IPC_C | CMP-06035-027361-1 | 6
120pf | CAP CER 0.1UF 50V X7R 0402 | C21 | CAP_0402 | 11868f565c42a9108669ba33697ecf6 | 1
100pf | CAP CER 0.1UF 50V X7R 0402 | C22 | CAP_0402 | 11868f565c42a9108669ba33697ecf6 | 1
20p | CAP CER 0.1UF 50V X7R 0402 | C33, C34, C111, C112 | CAP_0402 | 11868f565c42a9108669ba33697ecf6 | 4
12p | CAP CER 0.1UF 50V X7R 0402 | C35, C36 | CAP_0402 | 11868f565c42a9108669ba33697ecf6 | 2
1uF 0603 | Chip Multilayer Ceramic Capacitors for General Purpose, 0603, 10uF, X5R, 15%, 20%, 10V | C86 | FP-GRM188-0_15-MFG | CMP-06035-003612-1 | 1
10uF 0603 | Chip Multilayer Ceramic Capacitors for General Purpose, 0603, 10uF, X5R, 15%, 20%, 10V | C96 | FP-GRM188-0_15-MFG | CMP-06035-003612-1 | 1
1uF 0805 |  | C97, C101 | CAPC2013X145X50NL20T20 | CMP-2007-01676-1 | 2
15p | CAP CER 0.1UF 50V X7R 0402 | C98 | CAP_0402 | 11868f565c42a9108669ba33697ecf6 | 1
220n | CAP CER 0.1UF 50V X7R 0402 | C103, C107 | CAP_0402 | 11868f565c42a9108669ba33697ecf6 | 2
1uF 50V 1206 | Automotive Ceramic Capacitor, 1206, 1uF, 5%, X7R, 15%, 50V | C104 | FP-1206-L_3_2_0_2-W_1_6_0-IPC_B | CMP-04427-010925-1 | 1
YLED0402B | LED GREEN CLEAR 0402 SMD | D1 | FP-SM0402GC-MFG | CMP-35283-000001-2 | 1
DSK24 | BAT54W-HG3-18 Small Signal Schottky Diode, 30V/Sod-123 Rohs Compliant: Yes | D2, D7, D8 | FP-S8-V-3910_01-001-MFG | CMP-00030-105883403-1 | 3
PRTR5V0U2F,115 | TVS DIODE 5.5V 6XSON SOT886 | D3, D4, D5 | FP-SOT886-MFG | CMP-14436-000003-1 | 3
BLM18AG121SN1D | Chip Ferrite Bead, 0603, 120Ω @ 100MHz, 0.18Ω, 25%, 800mA | FB1, FB2, FB3 | FP-BLM18-0_15-t0_8-IPC_B | CMP-0686-00439-3 | 3
BLM15AG102SN1D | Chip Ferrite Bead, 0402, 1000Ω @ 100MHz, 0.65Ω, 25%, 300mA | FB4 | FP-BLM15-0_05-IPC_B | CMP-0686-00181-5 | 1
Connector 2PIn |  | J1, J2, JB1, JB2, JT | CON_2P | CON2P | 5
54548-2271 | 0.5 mm Pitch Easy-On(TM) Type FPC Connector, 1.2 mm Mated Height, Right Angle, ZIF, SMT, Bottom Contact, 22 Circuits, -20 to 85 degC, ELV and RoHS Compliant, Tape and Reel | J4, J5 | MOLX-54548-2271 | CMP-1241-00555-1 | 2
DFE201612E-R47M=P2 | Shielded Wirewound Inductor 0.47uH 20% 4500mA 0.026Ω 0806 (2016) | L1, L2, L3, L4, L5 | FP-DFE201612C-IPC_C | CMP-06042-012656-1 | 5
DFE252012F-100M=P2 | Shielded Wirewound Inductor 10uH 20% 950mA 0.48Ω 1008 (2520) | L6, L7 | FP-DFE252012C-IPC_B | CMP-06042-007232-1 | 2
SM05B-NSHSS-TB(LF)(SN) | CONN HEADER SMD R/A 5POS 1MM | PR1 | FP-SM05B-NSHSS-TB_LF_SN-MFG | CMP-17439-000615-2 | 1
DMG2301LK-7 | MOSFET P-CHA 20V 2.4A SOT23 | Q1 | FP-SOT23-IPC_B | CMP-12801-000081-1 | 1
DMG2302UK-7 | MOSFET N-CH 20V 2.8A SOT23 | Q2, Q4 | FP-SOT23-MFG | CMP-12801-000001-1 | 2
5.1k | RES 768kΩ ±1% 0.063W 0402 | R1, R4, R9, R11 | RES_0402 | 1029c3af85768c4190bb7ad29bc67b5 | 4
10k | RES 768kΩ ±1% 0.063W 0402 | R2, R3, R10, R13, R16, R31, R34, R36, R39, R40, R41, R43, R44, R57, R64, R65, R67, R70 | RES_0402 | 1029c3af85768c4190bb7ad29bc67b5 | 18
1.1k (1.5A) | RES 768kΩ ±1% 0.063W 0402 | R5 | RES_0402 | 1029c3af85768c4190bb7ad29bc67b5 | 1
100k | RES 768kΩ ±1% 0.063W 0402 | R6, R19, R20, R23, R26, R27, R28, R30, R32, R35, R38, R45, R49, R51, R53, R58, R60, R61, R69, R76 | RES_0402 | 1029c3af85768c4190bb7ad29bc67b5 | 20
590R (1.5A) | RES 768kΩ ±1% 0.063W 0402 | R7 | RES_0402 | 1029c3af85768c4190bb7ad29bc67b5 | 1
150k | RES 768kΩ ±1% 0.063W 0402 | R8 | RES_0402 | 1029c3af85768c4190bb7ad29bc67b5 | 1
1.5k | RES 768kΩ ±1% 0.063W 0402 | R12 | RES_0402 | 1029c3af85768c4190bb7ad29bc67b5 | 1
4.7k | RES 768kΩ ±1% 0.063W 0402 | R14, R15, R17, R18, R73, R74 | RES_0402 | 1029c3af85768c4190bb7ad29bc67b5 | 6
46.4k | RES 768kΩ ±1% 0.063W 0402 | R21 | RES_0402 | 1029c3af85768c4190bb7ad29bc67b5 | 1
511k | RES 768kΩ ±1% 0.063W 0402 | R22, R50 | RES_0402 | 1029c3af85768c4190bb7ad29bc67b5 | 2
91k | RES 768kΩ ±1% 0.063W 0402 | R24, R55 | RES_0402 | 1029c3af85768c4190bb7ad29bc67b5 | 2
33.2k | RES 768kΩ ±1% 0.063W 0402 | R25 | RES_0402 | 1029c3af85768c4190bb7ad29bc67b5 | 1
120k | RES 768kΩ ±1% 0.063W 0402 | R29 | RES_0402 | 1029c3af85768c4190bb7ad29bc67b5 | 1
240R | RES 768kΩ ±1% 0.063W 0402 | R33, R46, R47, R48 | RES_0402 | 1029c3af85768c4190bb7ad29bc67b5 | 4
200R | RES 768kΩ ±1% 0.063W 0402 | R37, R62 | RES_0402 | 1029c3af85768c4190bb7ad29bc67b5 | 2
22R | RES 768kΩ ±1% 0.063W 0402 | R42 | RES_0402 | 1029c3af85768c4190bb7ad29bc67b5 | 1
261k | RES 768kΩ ±1% 0.063W 0402 | R56 | RES_0402 | 1029c3af85768c4190bb7ad29bc67b5 | 1
200k | RES 768kΩ ±1% 0.063W 0402 | R59 | RES_0402 | 1029c3af85768c4190bb7ad29bc67b5 | 1
30k | RES 768kΩ ±1% 0.063W 0402 | R63 | RES_0402 | 1029c3af85768c4190bb7ad29bc67b5 | 1
4R | RES SMD 0603 1/4W 1% 10 OHM | R66 | FP-SR0603-MFG | CMP-03412-016018-1 | 1
10R | RES SMD 0603 1/4W 1% 10 OHM | R68 | FP-SR0603-MFG | CMP-03412-016018-1 | 1
510k | RES 768kΩ ±1% 0.063W 0402 | R71, R72 | RES_0402 | 1029c3af85768c4190bb7ad29bc67b5 | 2
S2B-PH-K-S(LF)(SN) | Male Header, Pitch 2 mm, 1 x 2 Position, Height 4.8 mm, Tail Length 3.4 mm, -25 to 85 degC, RoHS, Bulk | S1, S2, S3 | JST-S2B-PH-K-S_V | CMP-1755-00004-1 | 3
BQ24072TRGTR | 1.5 A USB-Friendly Li-Ion Battery Charger and Power-Path Management IC, 4.3 V, -40 to 85 degC, 16-pin QFN (RGT), Green (RoHS & no Sb/Br) | U1 | RGT0016C_V | CMP-0321-00268-2 | 1
ch340x | Applications Function:USB to serial；USB to Parallel USB Protocol:USB 2.0 Number of Channels:- Voltage - Supply:3.3V；5V Voltage - Supply:3.3V；5V Data Rate:2Mbps Operating Temperature:-20℃~+70℃ Operating Temperature:-20℃~+70℃ Current - Supply:- Quiescent Su | U2 | ch340x | ch340x | 1
k230d | Features:Calendar function；Power-on reset (POR)；True random number generator (TRNG)；Watchdog reset；Built-in general-purpose timer；Hardware CRC；Software reset | U3 | K230D | k230d | 1
TPS63802DLAR | IC POWER MANAGEMENT | U5, U8, U10 | FP-DLA0010A-MFG | CMP-04918-000005-1 | 3
TPS62823DLCR | IC REG BUCK ADJ 3A 8VSON-HR | U6, U7 | FP-DLC0008A-MFG | CMP-04918-000715-1 | 2
ai-m62-cbs(blifn4) | Utilized IC / Part:BL616 Interface Type:I2C；GPIO；UART；USB2.0；SPI；PWM；SDIO；I2S Output Power:22dBm Output Power:22dBm Voltage - Supply:2.97V~3.6V Voltage - Supply:2.97V~3.6V Receive Current:59mA Send Current:394mA Sensitivity:-98dBm Sensitivity:-98dBm Ope | U11 | AI-M62-CBS | ai-m62-cbs(blifn4) | 1
msm381acb026 | Direction:Omnidirectional Voltage - Supply:3.6V Voltage - Supply:3.6V Current Consumption:175uA Current Consumption:175uA S/N Ratio:64dB Sensitivity:-38dB Sensitivity:-38dB Impedance:170Ω Output Type:Analog output Length:2.75mm Width:1.85mm Height:0.9mm F | U13 | mems | msm381acb026 | 1
TPS61160ADRVT | White LED Driver with PWM Brightness Control, 2.7 to 18 V, -40 to 85 degC, 6-pin SON (DRV6), Green (RoHS & no Sb/Br) | U14, U15 | TPS61160ADRVT | TI-TPS6116XDRV6-1600X1000TP | 2
w25n02kvzeir | Memory Size:2Gbit Interface:SPI Clock Frequency:104MHz Voltage - Supply:2.7V~3.6V Voltage - Supply:2.7V~3.6V Write Cycle Time(tWC):- Page Program time (TPP):700us Block Erase Time(tBE):2ms Data Retention - TDR (Year):10 Years Operating Temperature:-40℃~+8 | U16 | w25n02 | w25n02kvzeir | 1
aht30 | Temperature Range:-40℃~+120℃ Temperature Range:-40℃~+120℃ Humidity:0%RH~100%RH Humidity:0%RH~100%RH Interface:I2C Voltage - Supply:2.2V~5.5V Voltage - Supply:2.2V~5.5V Current - Supply:570uA Humidity Tolerance:±3%RH Humidity Tolerance:±3%RH Temperature To | U17 | AHT30 | aht30_c45354925 | 1
type-c-31-m-12 | Connector Type:Type-C Protocol Standard:- Gender:Female Mounting Type:Surface Mount, Right Angle Number of Contacts:16P Number of Ports:1 Current Rating-Power:5A Voltage Rating:20V Connect-Disconnect Life:10,000 cycles Length:7.35mm Operating Temperature: | USBC1, USBC2 | TYPE-C-31-M-12 | type-c-31-m-12 | 2
ABS07-32.768KHZ-T | Crystal 32.768kHz ±20ppm (Tol) 12.5pF FUND 70kΩ 2-Pin CSMD T/R | Y1, Y3 | FP-ABS07-MFG | CMP-0447-00001-4 | 2
XL7EL89CKI-111YLC-24M | CRYSTAL 24.0000MHZ 6PF SMD | Y2 | FP-XRCGB_F_N-MFG | CMP-06054-000017-1 | 1
