vkorehov/LEAKCAM/(list of files, cad)

Other CAD files:
mechanical/enclosure/fit/fit.SLDASM
tools/cr10-fan-duct/fan_duct.SLDASM
mechanical/battery/LiPo_503450_1000mAh.step
mechanical/camera/M12_fisheye_222.SLDPRT
mechanical/enclosure/leds_cover.step
mechanical/enclosure/print/cover_seam_band.stl
mechanical/jst/SPH-002T_wires.SLDPRT
mechanical/models/mems.step
mechanical/ntc/MF55_NTC.SLDPRT
mechanical/pcb/MIFA.step
mechanical/usb/USB_Type-C_Plug.step
tools/cr10-fan-duct/models/E3D_V6_All_Metal_Hotend.step
tools/cr10-fan-duct/shroud.step
mechanical/camera/Arducam_B0370_OV5647_M12.step
mechanical/enclosure/fit/led_clamp_1.SLDPRT
mechanical/enclosure/leds_base.step
mechanical/enclosure/print/cover_fuzz_shell.stl
mechanical/models/K230D.step
mechanical/pcb/LEDS.step
tools/cr10-fan-duct/models/v6_reference.step
tools/cr10-fan-duct/v6_clamp.step
mechanical/enclosure/cover.SLDPRT
mechanical/enclosure/fit/led_clamp_2.SLDPRT
mechanical/enclosure/print/cover_seam_band_nofuzz.stl
mechanical/models/AI-M62-CBS.step
tools/cr10-fan-duct/models/40x40x10_DC_Fan.step
tools/cr10-fan-duct/part_duct.step
mechanical/enclosure/base.SLDPRT
mechanical/enclosure/fit/led_clamp_4.SLDPRT
mechanical/models/DSK24.step
tools/cr10-fan-duct/fang_front.stl
tools/cr10-fan-duct/models/E3D_V6_sw.step
mechanical/enclosure/cradle.SLDPRT
mechanical/enclosure/fit/led_clamp_3.SLDPRT
mechanical/models/FLEX_CON_22P.step
tools/cr10-fan-duct/fan_duct_fused.stl
mechanical/enclosure/fit/probe_legs.SLDPRT
mechanical/enclosure/led_clamp_3.step
mechanical/models/JNJ-LTJI0112W120.step
tools/cr10-fan-duct/fang_placed.stl
mechanical/enclosure/led_clamp_1.step
mechanical/models/XL-HD3535UWC-A2.step
tools/cr10-fan-duct/FANG.SLDPRT
mechanical/enclosure/led_clamp_2.step
mechanical/models/AHT30.step
tools/cr10-fan-duct/E3D_V6.SLDPRT
mechanical/enclosure/led_clamp_4.step
mechanical/models/w25n02.step
tools/cr10-fan-duct/fan_40x40x10.step
mechanical/enclosure/shell_base.step
mechanical/models/RGT0016C_V.step
tools/cr10-fan-duct/blower_5015.step
mechanical/enclosure/shell_cover.step
mechanical/models/TYPE-C-31-M-12.step
mechanical/enclosure/cover_outer.step
mechanical/enclosure/legs_cover.step
mechanical/enclosure/probe_legs.step
mechanical/enclosure/form_concept.step
mechanical/enclosure/base_outer.step
mechanical/enclosure/legs_base.step
mechanical/enclosure/form_outer.step
mechanical/enclosure/clamp_base_nx.SLDPRT
mechanical/enclosure/clamp_base_px.SLDPRT
mechanical/enclosure/clamp_cover.SLDPRT
mechanical/enclosure/clamp_cover_nx.SLDPRT
mechanical/enclosure/clamp_cover_px.SLDPRT
mechanical/battery/LiPo_503450_1000mAh.SLDPRT
mechanical/camera/Arducam_B0370_OV5647_M12.SLDPRT
mechanical/enclosure/fit/ISO7380_M2x10.SLDPRT
mechanical/enclosure/fit/ISO7380_M2x16.SLDPRT
mechanical/enclosure/fit/ISO7380_M2x20.SLDPRT
mechanical/enclosure/fit/ISO7380_M2x4.SLDPRT
mechanical/enclosure/fit/ISO7380_M2x5.SLDPRT
mechanical/enclosure/fit/ISO7380_M2x6.SLDPRT
mechanical/enclosure/fit/ISO7380_M2x8.SLDPRT
mechanical/pcb/LEDS.SLDPRT
mechanical/pcb/MIFA.SLDPRT
mechanical/usb/USB_Type-C_Plug.SLDPRT
tools/cr10-fan-duct/blower_5015.SLDPRT
tools/cr10-fan-duct/fan_40x40x10.SLDPRT
tools/cr10-fan-duct/part_duct.SLDPRT
tools/cr10-fan-duct/shroud.SLDPRT
tools/cr10-fan-duct/v6_clamp.SLDPRT
tools/cr10-fan-duct/v6_reference.step
