vkorehov/LEAKCAM/tools/power-bringup/README.md

# Bring-up: MIFA rev 1

Everything for the first power-on of a new board: what to solder by hand, how to wire the debug
port, the rail checks with a multimeter, and a small BL616 test firmware.

**Order**

1. Rail-to-GND resistance, power off (`power_check.py off`). Nothing soldered yet.
2. USB on USB-C 1, BL616 still blank (`power_check.py blank`): only VBAT and 3V3_SLEEP may be up.
3. Wire the debug port PR1, flash the test firmware ([bl616_powertest/](bl616_powertest)), switch
   the K230 rails on from its console and measure them (`power_check.py flashed`).
4. Solder the battery, thermistor, leak connectors and LED strips; check each with the test firmware.
5. Flash the product firmware ([firmware/BUILD.md](../../firmware/BUILD.md)).

## 1. Rail checks (multimeter)

```
python3 power_check.py all        # or: off | blank | flashed
```

The script names every pad to probe, checks the reading against the limits and appends it to
`power_check_<board>.csv`. The numbers in the pictures are the numbers it asks for. All probe
points are on the **top** side (the regulators are on the bottom, their output capacitors on top). Black lead on the black ring, red lead on the red ring.

| Full top side | Power corner (zoom) |
|---|---|
| top | zoom |

### Power tree

```
USB-C 1 (USBC1) -> U1 BQ24072 -> VBAT
VBAT -> U5 TPS63802, EN tied to VBAT (always on) ----------------> 3V3_SLEEP  (BL616 U11, PR1.6)
BL616 IO30 = K230_PWR (R19 100k pull-down: low while the BL616 is blank)
  -> R51 -> U6 TPS62823 EN -----------------------------------------> 0V8 (+ FB3 -> 0V8_MIPI)
            U6 power-good (R27 to K230_PWR) -> U8 TPS63802 ---------> 3V3
                                            -> U10 TPS63802 --------> 1V8 (+ FB1, FB2 -> 1V8_MIPI, 1V8_DDR)
            U10 power-good = PG_1V8 (R28 to K230_PWR) -> U7 TPS62823 -> 1V1
            U7 power-good = RSTN (R30 to 1V8, C23) -> K230 reset; the BL616 holds it low through Q4
```

### Limits

| # | Rail | + pad | GND pad | off: ohms to GND | blank BL616 | rails on | battery only |
|---|---|---|---|---|---|---|---|
| 1 | VUSB | C2.1 | C2.2 | >= 20 | 4.75 .. 5.25 V | 4.75 .. 5.25 V | <= 0.3 V |
| 2 | BAT | C11.1 | C11.2 | >= 20 | (no battery) | (no battery) | the cell, 3.0 .. 4.25 V |
| 3 | VBAT | C3.1 | C3.2 | >= 20 | 4.1 .. 4.6 V | 4.1 .. 4.6 V | BAT - ~0.1 V |
| 4 | 3V3_SLEEP | C14.1 | C14.2 | >= 20 | 3.2 .. 3.4 V | 3.2 .. 3.4 V | 3.2 .. 3.4 V |
| 5 | K230_PWR | R19.2 | R19.1 | | <= 0.3 V | 3.0 .. 3.4 V | <= 0.3 V |
| 6 | 0V8 | C18.1 | C18.2 | >= 2 | <= 0.1 V | 0.76 .. 0.84 V | <= 0.1 V |
| 7 | 3V3 | C87.1 | C87.2 | >= 20 | <= 0.1 V | 3.2 .. 3.4 V | <= 0.1 V |
| 8 | 1V8 | C89.1 | C89.2 | >= 10 | <= 0.1 V | 1.71 .. 1.85 V | <= 0.1 V |
| 9 | PG_1V8 | R28.1 | C89.2 | | | 3.0 .. 3.4 V | |
| 10 | 1V1 | C20.1 | C20.2 | >= 5 | <= 0.1 V | 1.05 .. 1.15 V | <= 0.1 V |
| 11 | RSTN | R30.2 | C23.2 | | | ~0 V (held) or ~1.8 V (released) |
| 12 | 0V8_MIPI | C41.1 | C41.2 | | | 0.76 .. 0.84 V |
| 13 | 1V8_MIPI | FB1.2 | C89.2 | | | 1.71 .. 1.85 V |
| 14 | 1V8_DDR | FB2.2 | C89.2 | | | 1.71 .. 1.85 V |

Nominal outputs from the feedback dividers: 3V3_SLEEP and 3V3 0.5 x (1 + 511k/91k) = 3.31 V,
1V8 0.5 x (1 + 51k/20k) = 1.78 V, 0V8 0.6 x (1 + 33k/100k) = 0.80 V, 1V1 0.6 x (1 + 100k/120k) =
1.10 V. VBAT is the BQ24072 output: about 4.4 V on USB without a battery, the battery voltage on
battery.

- **off**: unplug USB and the battery, measure each rail to GND in ohms. The reading climbs while
  the capacitors charge; take it after about 3 s. Below the minimum is a short: stop.
- **blank**: USB on USB-C 1, no battery, nothing on PR1. R19 holds K230_PWR low, so only **VBAT and
  3V3_SLEEP** are up. Any K230 rail above 0.1 V means a regulator runs without its enable: stop.
- **battery only** (`battery` in the script): USB unplugged, the cell on JB1. The charger passes the cell
  to VBAT, so **BAT, VBAT and 3V3_SLEEP** are up and the K230 rails off (unless the BL616 firmware has
  switched them on). VUSB reads ~0 V.
- **rails on** (`flashed` in the script): with the test firmware, `pt_on` drives K230_PWR high and
  the chain brings up **0V8, then 3V3 and 1V8, then 1V1**. The product firmware does the same on
  its first boot. RSTN is ~0 V while the K230 is held in reset and ~1.8 V once released.

A rail at the wrong voltage, or a regulator that gets hot: power off at once. The X-ray of the
first boards showed U5 (3V3_SLEEP) and U6/U7 (0V8/1V1) slightly off their pads; these checks are
what confirms or rules that out.

### Test record: battery only, 2026-10-17

Rev 1 board, the cell on JB1 (3.9 V), USB unplugged. Wired from `hookup_battery.png` (the cells and the
thermistor) and probed at the points in `battery_only.png`.

| Wiring | Probe points |
|---|---|
| battery wiring | battery only |

| # | Rail | Measured | Limit | |
|---|---|---|---|---|
| 2 | BAT | ~3.9 V | the cell | pass |
| 3 | VBAT | ~3.9 V | BAT - ~0.1 V | pass |
| 4 | 3V3_SLEEP | 3.298 V | 3.2 .. 3.4 V (3.31 nominal) | pass |

**Result: pass.** U5 (TPS63802) regulates from the battery. That is one of the parts the X-ray showed slightly
off its pads, and it works. The charger U1 passes the cell to VBAT.

### Test record: charging from USB-C 1, 2026-10-17

The cell on JB1 (3.9 V) and the thermistor on JT, USB on USB-C 1. Probe points and required readings in
`charging.png`: VUSB 4.75 .. 5.25 V, BAT above the cell and rising to 4.20 V, VBAT about 0.2 V above BAT,
3V3_SLEEP 3.2 .. 3.4 V. The red LED D1 (bottom side, by U1) is on while the cell charges (U1 /CHG). The
charger is set to about 0.89 A (ISET R7 1 k), with a 1.0 A input limit (ILIM R5 1.5 k) and a 6.3 h safety
timer (TMR R21 47 k).

charging

| # | Rail | Measured | Limit | |
|---|---|---|---|---|
| 1 | VUSB | 5.2 V | 4.75 .. 5.25 V | pass |
| 2 | BAT | 3.9 V, not rising | above the cell, rising to 4.20 V | **fail** |
| 3 | VBAT | 4.2 V | BAT + ~0.2 V | (U1 regulates OUT, not charging) |
| 4 | 3V3_SLEEP | (not measured) | 3.2 .. 3.4 V | |
| | D1 (charging) | on | on, then off when full | (on in a TS fault too) |

Result: **fail, no charging**: [bug-001](../../bugs/bug-001/README.md) (U1 is the BQ24072T; its TS input has no
internal bias, so the NTC alone reads "hot"). Retest after the workaround there.

### Test record: K230 rails and K230 boot ROM, 2026-10-17

The cell on JB1, the BL616 test firmware from section 3 on PR1 (console over USB, the PR1 cable with 6.7 k on
its CC wire). Probe points and required readings in `k230_rails.png`.

K230 rails

| Step | Result | |
|---|---|---|
| `pt_status` (rails off) | K230 rails off, reset held; leak node 1649 mV dry; AHT20 53.9 %RH, 25.8 C | pass |
| `pt_on` | `3V3 up 1.726 ms after K230_PWR` (estimate ~3 ms; soft start) | pass |
| K230_PWR, 0V8, 3V3, 1V8, 1V1, RSTN, 0V8_MIPI, 1V8_MIPI, 1V8_DDR | all within the limits on the sheet (multimeter) | pass |
| PG_1V8 | not probed (pad too small); implied: 1V1 is up and U7 only starts on PG_1V8 | pass |
| `pt_off` | `3V3 gone 12 ms` (expected 56-82 ms through RD1/RD2: faster, to look at) | note |
| USB-C 1 to a Mac with the rails on | VUSB ~2.2 V, the Mac never turns on VBUS: [bug-002](../../bugs/bug-002/README.md) | **fail** |
| `pt_off`, cable in, `pt_on`, `pt_run` | VUSB 5 V (PGOOD low); the K230 ROM enumerates: `29f1:0230 Canaan K230 USB Boot Device` | pass |

| Debug serial on USBC2 | `1a86:7523 CH340` on `/dev/ttyUSB0`; `pt_hold` + `pt_run`: the K230 ROM prints `boot failed with exit code 13` at 115200 (blank NAND) and enumerates again as `29f1:0230` | pass |

| [k230_hello](k230_hello) from SRAM over USB (`make run`, nothing written to the NAND) | `LEAKCAM K230 hello: running from SRAM, hart 0`, then `status n=... mcycle=...` once a second (800 M cycles apart: the core runs at 800 MHz from the ROM); K230_ALIVE toggles in `pt_status` | pass |

| Full image flashed to NAND (pad check OK), reset | ROM: `boot failed with exit code 13` (= file error in the boot medium, Canaan FAQ). BOOT1 read 0.5 V with IO27 parked; driven low now (`pt_boot1`), ~0 V: still 13 | **fail** |
| Plain SPL (`fn_u-boot-spl.bin`) written over the EVB `swap_fn` one at offset 0 | `U-Boot SPL 2022.10`, DDR training `Firmware run has completed 2667`, `Winbond SPI NAND was found`, `OpenSBI v0.9`; then silent (K230_ALIVE static) | SPL + DDR pass; OpenSBI/RT-Smart open |

Boot straps: [boot_straps_board.png](boot_straps_board.png) (where), [boot_straps.png](boot_straps.png) (zoom).
`pt_boot1 high` + `pt_hold` + `pt_run` puts a flashed K230 into USB boot (the ROM tries an SD card, fails,
and drops to USB): no B1 short needed for re-flashing.

Result: all four K230 rails good, the K230 boots its ROM and runs our code from SRAM, the debug UART works;
the SPL boots from NAND and DDR trains; OpenSBI stops after its first line; charging (bug-001) and USB-C attach with the rails on
(bug-002) still open.

## 2. Debug port PR1 (bottom side)

bottom side wiring

PR1 debug cable, zoom

PR1 is the BL616's own USB: no USB-serial bridge is needed, a USB cable is soldered to the pads.
Cut a USB-A cable, solder **green D+ to pad 1, white D- to pad 2, black GND to pad 3**. Cut the red
VBUS wire back and tape it: the board powers the BL616 itself (USB-C 1 or the battery); pad 6 is the
board's 3V3_SLEEP, an output.

A **USB-C cable** (for a Mac or any USB-C port) has a fifth wire, usually yellow: CC. A USB-C port stays off until it
sees 5.1 k from CC to GND, so fit **5.1 k (4.7 .. 5.6 k) between the yellow and the black wire**; D+/D-/GND as above,
red VBUS still cut and taped (the port turns on 5 V once CC is terminated). Without it the Mac shows nothing. A
USB-C to USB-A adapter or a hub on the computer side does this itself. On macOS the port is `/dev/cu.usbmodem*`.

- **Boot into flash mode**: link pad 4 (BOOT) to pad 6 (3V3_SLEEP), then touch pad 5 (EN) to GND
  (pad 3) for a moment and let go. The ROM enumerates as `Bouffalo CDC` (349b:6160), `/dev/ttyACM0`.
- **Run**: remove the 4-6 link and touch pad 5 to GND again. The firmware's console appears on the
  same cable as `/dev/ttyACM0` (any baud rate): `picocom /dev/ttyACM0`.

## 3. BL616 test firmware

[bl616_powertest/](bl616_powertest): switches the K230 rails and tests the BL616-side hardware
from the PR1 console. Not the product firmware; flash that afterwards.

```
cd bl616_powertest
make                              # arm64 host: builds in the K230 build container by itself
make flash COMX=/dev/ttyACM0      # BL616 in flash mode (above); then remove the link and reset
```

On an arm64 host the RISC-V toolchain (x86-64 only) runs in the `k230-rtos-sdk-build:arm64-x86tc`
container from [firmware/BUILD.md](../../firmware/BUILD.md) section 2.2, which `make` starts; the
SDK sits next to LEAKCAM (`~/k230d-hw/bouffalo_sdk`). `make flash` runs in the same container with the
x86-64 `BLFlashCommand-ubuntu` (the SDK's `BLFlashCommand-arm` is 32-bit armhf and does not start on an arm64-only
host). Without the `dialout` group: `sudo setfacl -m u:$USER:rw /dev/ttyACM0` (again after each re-plug).

Rails start **off**; nothing switches until you type. Commands:

| Command | Does | Expect |
|---|---|---|
| `pt_status` | everything at a glance (printed when the console opens) | |
| `pt_mon [on\|off]` | one status line per second | |
| `pt_on` | K230 rails on, K230 held in reset, 3V3 ramp timed | `OK: 3V3 up ~3 ms`; then measure with `power_check.py flashed` |
| `pt_off` | rails off, 3V3 discharge timed | `OK: 3V3 gone 56-82 ms` |
| `pt_run` / `pt_hold` | release / hold the K230 reset | blank NAND: the K230 ROM enumerates on USB-C 1 as `29f1:0230` (all four K230 rails good) |
| `pt_cycle [n]` | n power cycles with min/max timing | |
| `pt_uart on\|off\|send <text>` | UART0 = the K230 link (IO21 TX, IO22 RX, 115200 8N1): one message per second, received bytes echoed | only while 3V3 is up |
| `pt_i2c [scan]` | AHT20 humidity/temperature, or a scan of I2C0 | `0x38` |
| `pt_usb` | USB cable on USB-C 1 (BQ24072 PGOOD); plug/unplug is reported live | |
| `pt_leak` | leak node (IO20, ADC) and the resistance across S1..S3 | dry ~1650 mV; a 100k across S1 reads ~100 kohm |

The BL616 sees the switched 3V3 through the SDIO pull-ups (read as inputs only, never driven);
0V8 is implied (3V3's regulator is enabled by 0V8's power-good); 1V8 and 1V1 need the multimeter
or `pt_run`. Each test can be left out: set it to 0 in
[tests.h](bl616_powertest/tests.h) and rebuild.

### K230 hello (no NAND needed)

[k230_hello/](k230_hello): 0.8 KB of bare-metal RISC-V that the boot ROM loads into SRAM over USB-C 1 and runs:
a status line per second on the debug UART (USB-C 2, `/dev/ttyUSB0`, 115200) and a heartbeat on K230_ALIVE.
For checking a board's K230 before the NAND holds anything.

```
cd k230_hello
make                 # builds in the K230 build container
make run             # K230 in USB boot mode (29f1:0230; after pt_on + pt_run on a blank NAND)
```

In this state UART0 register reads return 0 (writes work), so the program paces characters by time rather
than polling THRE. The flasher (`k230_flash_cli`) is x86-64 only; `make run` runs it in the build container
with `timeout` inside the container: a `timeout` around `docker run` only kills the client and leaves the
container holding the K230's USB.

## 4. Hand-soldered parts

top side wiring

The bottom side (PR1 cable, leak probes, camera 2) is the picture in section 2.

- **Battery** (503450 LiPo, [EXTERNAL_PARTS.md](../../EXTERNAL_PARTS.md)): cut the plug off,
  **measure which lead is positive**, solder it to JB1 pin 1 (BAT), the other to pin 2 (GND). No
  reverse protection on the board. A second cell goes to JB2 the same way, voltages matched to
  within 0.1 V first.
- **Thermistor** (MF52D 10k B3435): JT pin 1 (TS) and pin 2 (GND), no polarity; glue the bead to
  the battery. Without it the charger sees a TS fault and does not charge (the board still runs on
  USB).
- **Leak connectors S1..S3** (JST PH 2-pin, through-hole, bottom side): no polarity. Check with
  `pt_leak`: dry ~1650 mV; a wet probe or a resistor across it pulls the node down.
- **Cameras**: 15-to-22 pin Pi Zero cable, 22-pin end into J5 (camera 1, top) and J4 (camera 2,
  bottom), contacts as on a Pi Zero.
- **B1_P / B1_N**: short while the K230 powers up to force its USB flash mode (BUILD.md 3.2).

### LED strips

The four strips (A..D, cut from the panel) carry 2 white + 2 IR LEDs each. **Each colour is one
series chain through all four strips**: 8 white LEDs on J1 (about 22 V from U14) and 8 IR LEDs on
J2 (about 11 V from U15). Twist each go/return pair.

LED strip wiring

The wires, numbered in soldering order (made to print in black and white: white chain solid, IR dashed).

- IR pairs (J6, J8, J10, J12): **pin 2 = +**, pin 1 = - (measured on the rev 1 strips, 2026-10-16).
  The JNJ footprint does not number its pads like the datasheet: its anode pad (right) is "1", the
  cathode pad (left) "3", the centre "2". The IR chain as built runs J2 + > D > C > B > A > J2 -
  (the picture shows it so).
- The board has no +/- marks at the wire pads (only J3 .. J12, J1, J2) and no square pin 1.
- White pairs (J3, J7, J9, J11): pin 2 = + (Xinglight footprint: cathode pad "1" left, anode "2"
  right). **Confirm before wiring**: a bench supply at 6.5 V with a 2 mA limit across one strip's white pair lights both LEDs
  faintly in the right polarity only (IR pair: 3.5 V, 2 mA, check with a phone camera). A chain
  wired backwards sees the boost converter's open-circuit voltage in reverse.
- The LEDs are driven by the K230 (PWM), so the chains are tested with the K230 firmware
  (`leakcam_capture -b`), not from the BL616.

#### Test record: rev 1 strips, 2026-10-16

The four strips are wired as in `led_wiring.png` above (IR chain J2 + > D > C > B > A > J2 -), and each whole chain was
checked from a bench supply, raised until the LEDs light.

| Chain | LEDs in series | Lights from | Per LED | Running point (LED_STRIPS.txt) |
|---|---|---|---|---|
| White (J1) | 8 | 19.6 V | 2.45 V | ~22 V at 64 mA |
| IR (J2) | 8 | 10.0 V | 1.25 V | ~11 V at 133 mA |

- **Result: pass.** All 16 LEDs light, both chains are continuous through all four strips, and every strip's
  pads have + on pin 2.
- **Thresholds are as expected** for a white and an 850 nm LED (about 2.5 V and 1.2-1.3 V each). The running
  points are 2-3 V higher, well under the TPS61161's 38 V over-voltage limit, so the drivers regulate normally.
- **IR was first wired reversed** (pin 1 as +, from the first version of this page), so the chain did not light.
  It was corrected by swapping the two wires at J2. During the first check one IR pair saw up to 14 V in
  reverse (about 7 V per LED, over their 5 V rating); all IR LEDs light now.
- **Still to do:** drive both chains from the board with `leakcam_capture -b` (white and IR separately and
  dimmed), and check the brightness against section 8 of LED_STRIPS.txt.

## Files

- `testpoints.json`: probe pads and limits per phase
- `power_check.py`: the interactive multimeter check, writes the CSV log
- `render_testpoints.py`: redraws the pictures here: probe points (`top.png`, `top_power_zoom.png`), wiring
  (`hookup_top.png`, `hookup_bottom.png`, `hookup_battery.png`, `led_wiring.png`) and the sheets used in the
  test records (`battery_only.png`, `charging.png`) from the ODB++ of the ordered board (git
  `11a6a38`), and refuses to draw if a probe pad is not on the net the table says
- `bl616_powertest/`: the BL616 test firmware
