vkorehov/LEAKCAM/(list of files, drawings)

Other design files:
AHT30.PcbLib
AI-M62-CBS.PcbLib
CAM.SchDoc
DBG.SchDoc
DSK24.PcbLib
FLASH.SchDoc
FLEX_PCB_CON.PcbLib
K230D.PcbLib
LEAKCAM.PcbLib
LEAKCAM.PrjPcb
LEAKCAM.SchDoc
LEDS.PcbLib
LEDS.SchDoc
mechanical/models/easyeda/C28323.json
mechanical/models/easyeda/C165948.json
mechanical/models/easyeda/C324075.json
mechanical/models/easyeda/C2757850.json
mechanical/models/easyeda/C3035748.json
mechanical/models/easyeda/C3646951.json
mechanical/models/easyeda/C6081229.json
mechanical/models/easyeda/C17626844.json
mechanical/models/easyeda/C22459552.json
mechanical/models/easyeda/C51928208.json
MEMS.PcbLib
MIFA.PcbDoc
MIFA.PcbLib
MIFI.SchLib
POWER.SchDoc
SENS.SchDoc
TF_PUSH.PcbLib
TPS61160ADRVT.PcbLib
TPS63070RNMR.PcbLib
TYPE-C-31-M-12.PcbLib
WIFI.SchDoc
