vkorehov/LEAKCAM/firmware/bl616/k230_link.c

#include "k230_link.h"

#include <stdio.h>
#include <stdlib.h>
#include <string.h>

#include "bflb_uart.h"

static char line[LINK_MAX_LINE];
static unsigned len;
static bool in_frame;

/* receive side: last accepted seq (-1 = none since the last READY / reset) and its answer */
static int rx_last = -1;
static uint8_t rx_last_code;       /* 0 = ACK, else the NAK code */
static bool rx_last_ready;         /* the last accepted command was READY */
static uint8_t (*reply_fn)(const struct link_msg *m);

/* transmit side: one command at a time; the BL616 only sends WAKE, once per READY */
static char tx_cmd[16], tx_arg[40];
static bool tx_pending;             /* a command is waiting to be sent or for its ACK */
static uint8_t tx_seq;              /* seq of the command in flight */
static uint8_t tx_next;             /* next seq to hand out */
static unsigned tx_sends;           /* sends of the command in flight, 0 = not sent yet */
static uint64_t tx_at;              /* time of the last send */
static struct link_result result;
static bool result_ready;

static struct bflb_device_s *uart(void)
{
    static struct bflb_device_s *u;
    if (!u)
        u = bflb_device_get_by_name("uart0");
    return u;
}

void link_reset(void)
{
    len = 0;
    in_frame = false;
    rx_last = -1;
    tx_pending = false;
    tx_sends = 0;
    tx_next = 0;
    result_ready = false;
}

void link_set_reply(uint8_t (*reply)(const struct link_msg *m))
{
    reply_fn = reply;
}

static void send_frame(uint8_t seq, const char *cmd, const char *arg)
{
    char body[LINK_MAX_LINE], frame[LINK_MAX_LINE + 8];
    if (arg && *arg)
        snprintf(body, sizeof(body), "%u,%s,%s", seq, cmd, arg);
    else
        snprintf(body, sizeof(body), "%u,%s", seq, cmd);
    int n = snprintf(frame, sizeof(frame), "$%s*%02X\n", body, link_crc8(body, body + strlen(body)));
    for (int i = 0; i < n; i++)
        bflb_uart_putchar(uart(), frame[i]);
}

static void send_answer(uint8_t seq, uint8_t code)
{
    char s[8];
    if (code)
        snprintf(s, sizeof(s), "%u,%u", seq, code);
    else
        snprintf(s, sizeof(s), "%u", seq);
    send_frame(seq, code ? "NAK" : "ACK", s);   /* an answer's own seq is not checked by anyone */
}

/* the command in flight has ended: drop it and keep how, for link_service() to report */
static void tx_done(enum link_end end)
{
    result.end = end;
    snprintf(result.cmd, sizeof(result.cmd), "%s", tx_cmd);
    result_ready = true;
    tx_pending = false;
    tx_sends = 0;
}

static bool parse(struct link_msg *out)
{
    char *star = strchr(line, '*');
    if (!star || star[1] == 0 || star[2] == 0)
        return false;
    if (strtoul(star + 1, NULL, 16) != link_crc8(line, star))
        return false;
    *star = 0;

    char *end;
    unsigned long seq = strtoul(line, &end, 10);
    if (end == line || *end != ',' || seq > 255)
        return false;
    char *cmd = end + 1, *comma = strchr(cmd, ',');
    if (comma)
        *comma = 0;
    if (!*cmd || strlen(cmd) >= sizeof(out->cmd))
        return false;
    strcpy(out->cmd, cmd);
    out->seq = (uint8_t)seq;
    out->has_arg = comma != NULL;
    out->arg = comma ? strtoul(comma + 1, NULL, 10) : 0;
    snprintf(out->args, sizeof(out->args), "%s", comma ? comma + 1 : "");
    return true;
}

/* a whole valid frame: consume ACKs and duplicates, answer and deliver the rest. The agent
 * accepts everything we send, so its only answer is ACK */
static bool accept(struct link_msg *m)
{
    if (strcmp(m->cmd, "ACK") == 0) {
        if (tx_pending && tx_sends && m->has_arg && m->arg == tx_seq)
            tx_done(LINK_ACKED);
        return false;                   /* a stale answer is simply ignored */
    }
    bool ready = strcmp(m->cmd, "READY") == 0;
    /* a READY is a (re)started agent, whose seq starts over, unless it repeats the READY we just
     * accepted (our answer was lost). A restarted agent that happens to reuse that seq is taken
     * for a repeat once; its WAKE wait times out and its next READY, with seq + 1, gets through. */
    if (ready && !(rx_last == m->seq && rx_last_ready)) {
        rx_last = -1;
        tx_pending = false;             /* whatever we were sending was for the old agent */
        tx_sends = 0;
    }
    if (rx_last == m->seq) {            /* our answer was lost and it was sent again */
        send_answer(m->seq, rx_last_code);
        return false;
    }
    rx_last = m->seq;
    rx_last_ready = ready;
    rx_last_code = reply_fn ? reply_fn(m) : 0;
    send_answer(m->seq, rx_last_code);
    return rx_last_code == 0;
}

bool link_poll(struct link_msg *out)
{
    int c;
    while ((c = bflb_uart_getchar(uart())) >= 0) {
        if (c == '$') {             /* a new frame always restarts, noise before it is dropped */
            in_frame = true;
            len = 0;
            continue;
        }
        if (!in_frame)
            continue;
        if (c == '\r')
            continue;
        if (c == '\n') {
            in_frame = false;
            line[len] = 0;
            if (parse(out) && accept(out))
                return true;
            continue;
        }
        if (len >= sizeof(line) - 1) {  /* over-long garbage */
            in_frame = false;
            continue;
        }
        line[len++] = (char)c;
    }
    return false;
}

bool link_send_cmd(const char *cmd, const char *arg)
{
    if (tx_pending)
        return false;
    snprintf(tx_cmd, sizeof(tx_cmd), "%s", cmd);
    snprintf(tx_arg, sizeof(tx_arg), "%s", arg ? arg : "");
    tx_pending = true;
    return true;
}

const struct link_result *link_service(uint64_t now_ms)
{
    if (result_ready) {
        result_ready = false;
        return &result;
    }
    if (!tx_pending)
        return NULL;
    if (tx_sends && now_ms - tx_at < LINK_ACK_TIMEOUT_MS)
        return NULL;
    if (tx_sends >= LINK_TRIES) {
        tx_done(LINK_TIMED_OUT);
        result_ready = false;
        return &result;
    }
    if (!tx_sends)
        tx_seq = tx_next++;
    send_frame(tx_seq, tx_cmd, tx_arg);
    tx_sends++;
    tx_at = now_ms;
    return NULL;
}
