vkorehov/LEAKCAM/tools/power-bringup/bl616_powertest/main.c

/*
 * LEAKCAM BL616 bring-up firmware: board tests on the PR1 USB console (not the product firmware).
 * Which tests are built in: tests.h. Rails start OFF at boot; nothing switches until you type.
 *
 *   pt_status          everything at a glance
 *   pt_mon [on|off]    one status line per second
 *
 * POWER  pt_on / pt_off    K230 rails on (K230 held in reset) / off, with the 3V3 ramp and
 *                          discharge timed; pt_run releases the reset (a blank NAND then makes the
 *                          K230 ROM enumerate on USB-C 1 as 29f1:0230), pt_hold holds it again,
 *                          pt_cycle [n] power-cycles n times.
 *        What the BL616 sees of the rails: the switched 3V3 through the 10 k pull-ups on the SDIO
 *        lines, read as inputs only. 0V8 is implied (U8 is enabled by U6's power-good); 1V8 and
 *        1V1 are not visible: measure them (power_check.py) or use pt_run.
 * UART   pt_uart on|off|send <text>   UART0 = the K230 link (IO21 TX, IO22 RX, 115200 8N1): one
 *                          message per second, anything received is echoed here. Only while 3V3 is
 *                          up (the link pins are pulled up to it); pt_off stops it first.
 * I2C    pt_i2c [scan]     AHT20 reading (0x38), or a scan of the whole bus (IO28/IO29, 3V3_SLEEP)
 * USB    pt_usb            USB cable on USB-C 1 (BQ24072 PGOOD); plugging and unplugging is reported
 * LEAK   pt_leak           probe node (IO20, ADC) and the probe resistance across S1..S3
 * BOOT1  pt_boot1 low|high|park   IO27 -> RBT1 10k -> K230 BOOT1. Low at start: with IO27 parked, BOOT1 read
 *                          0.5 V on rev 1 (2026-10-17), at the 1.8 V bank's VIL, and the ROM did not boot the
 *                          NAND. High = the ROM's SD-card path, which fails into USB boot (re-flashing).
 */
#include <stdbool.h>
#include <stdint.h>
#include <stdio.h>
#include <stdlib.h>
#include <string.h>

#include "FreeRTOS.h"
#include "task.h"
#include "semphr.h"
#include "board.h"
#include "bflb_gpio.h"
#include "bflb_mtimer.h"
#include "shell.h"
#include "tests.h"

#include "../../../firmware/bl616/board_pins.h"   /* one pin map for the product and this test */

#if PT_TEST_UART
#include "bflb_uart.h"
#endif
#if PT_TEST_I2C
#include "../../../firmware/bl616/aht20.h"
#include "bflb_i2c.h"
#endif
#if PT_TEST_LEAK
#include "bflb_adc.h"
#endif

#define PIN_BOOT1_FORCE   GPIO_PIN_27              /* IO27 -> RBT1 10k -> K230 BOOT1: driven low (NAND boot) */

static struct bflb_device_s *gpio;
static SemaphoreHandle_t hw;                       /* commands and the monitor share the peripherals */
static bool rails_on, reset_held = true, monitor;
static volatile bool console_open;

static void park(uint8_t pin)
{
    /* analog: no output, no input buffer (a half-powered pull-up cannot cause shoot-through) */
    bflb_gpio_init(gpio, pin, GPIO_ANALOG | GPIO_FLOAT | GPIO_DRV_0);
}

enum boot1_mode { BOOT1_LOW, BOOT1_HIGH, BOOT1_PARK };
static enum boot1_mode boot1 = BOOT1_PARK;
static const char *const boot1_name[] = { "low (NAND boot)", "HIGH (ROM tries SD, then USB boot)", "parked (floating)" };

/* ---------------------------------------------------------------- K230 power ---- */
static const uint8_t sense_pins[] = { PIN_SD_D0, PIN_SD_D1, PIN_SD_D2, PIN_SD_D3, PIN_SD_CMD };
#define SENSE_ALL ((unsigned)sizeof(sense_pins))
#define SENSE_UP  (SENSE_ALL - 1)                  /* one line may be held by the K230 pad itself */

static void reset_hold(bool held)
{
    /* inverted by Q4: IO00 high pulls RSTN low */
    if (held)
        bflb_gpio_set(gpio, PIN_K230_RSTN);
    else
        bflb_gpio_reset(gpio, PIN_K230_RSTN);
    reset_held = held;
}

/* SDIO lines (10 k pull-ups to the switched 3V3) that read high; they are plain inputs */
static unsigned sense_high(void)
{
    unsigned n = 0;
    for (unsigned i = 0; i < SENSE_ALL; i++)
        n += bflb_gpio_read(gpio, sense_pins[i]) ? 1 : 0;
    return n;
}

#if PT_TEST_UART
static struct bflb_device_s *uart0;
static bool uart_on;
static unsigned uart_count;

static void uart_stop(void)
{
    if (!uart_on)
        return;
    bflb_uart_deinit(uart0);               /* first, so TX no longer drives the pad high */
    park(PIN_LINK_TX);
    park(PIN_LINK_RX);
    uart_on = false;
}

static bool uart_start(void)
{
    if (!rails_on || sense_high() < SENSE_UP)
        return false;
    struct bflb_uart_config_s cfg = {
        .baudrate = 115200, .direction = UART_DIRECTION_TXRX, .data_bits = UART_DATA_BITS_8,
        .stop_bits = UART_STOP_BITS_1, .parity = UART_PARITY_NONE, .bit_order = UART_LSB_FIRST,
        .flow_ctrl = UART_FLOWCTRL_NONE, .tx_fifo_threshold = 7, .rx_fifo_threshold = 7,
    };
    bflb_gpio_uart_init(gpio, PIN_LINK_TX, GPIO_UART_FUNC_UART0_TX);
    bflb_gpio_uart_init(gpio, PIN_LINK_RX, GPIO_UART_FUNC_UART0_RX);
    bflb_uart_init(uart0, &cfg);
    uart_on = true;
    return true;
}

static void uart_send(const char *s)
{
    while (*s)
        bflb_uart_putchar(uart0, *s++);
}
#endif

#if PT_TEST_POWER
#define RAMP_TIMEOUT_US   100000                   /* 3V3 at 90 % ~3 ms after K230_PWR (firmware/sim) */
#define FALL_TIMEOUT_US   1000000
#define OFF_SETTLE_MS     300                      /* as k230_power.c: let 1V8/3V3 discharge fully */

/* ramp time in us, 0 on timeout (the rails are switched off again) */
static uint32_t rails_on_timed(void)
{
    if (rails_on)
        return 1;
    reset_hold(true);
    uint64_t t0 = bflb_mtimer_get_time_us();
    bflb_gpio_set(gpio, PIN_K230_PWR);
    rails_on = true;
    while (sense_high() < SENSE_UP) {
        if (bflb_mtimer_get_time_us() - t0 > RAMP_TIMEOUT_US) {
            bflb_gpio_reset(gpio, PIN_K230_PWR);
            rails_on = false;
            return 0;
        }
    }
    return (uint32_t)(bflb_mtimer_get_time_us() - t0);
}

static uint32_t rails_off_timed(void)
{
    if (!rails_on)
        return 1;
#if PT_TEST_UART
    uart_stop();
#endif
    reset_hold(true);
    uint64_t t0 = bflb_mtimer_get_time_us();
    bflb_gpio_reset(gpio, PIN_K230_PWR);
    rails_on = false;
    while (sense_high() != 0) {
        if (bflb_mtimer_get_time_us() - t0 > FALL_TIMEOUT_US)
            return 0;
    }
    uint32_t t = (uint32_t)(bflb_mtimer_get_time_us() - t0);
    vTaskDelay(pdMS_TO_TICKS(OFF_SETTLE_MS));
    return t;
}
#endif

/* ---------------------------------------------------------------- I2C / AHT20 ---- */
#if PT_TEST_I2C
/* 1 if the AHT20 answered; rh/t in tenths */
static enum aht20_result aht20_read(int *rh, int *t)
{
    enum aht20_result r = aht20_start();
    return r != AHT20_OK ? r : aht20_finish(rh, t);
}

static const char *aht20_err(enum aht20_result r)
{
    return r == AHT20_ERR_I2C ? "no ACK (missing, bus stuck or 3V3_SLEEP pull-ups off)"
         : r == AHT20_ERR_BUSY ? "busy after 100 ms" : r == AHT20_ERR_CRC ? "CRC error" : "?";
}
#endif

/* ---------------------------------------------------------------- leak probes ---- */
#if PT_TEST_LEAK
#define V_SLEEP_MV 3310                            /* 3V3_SLEEP, 0.5 x (1 + 511k/91k) */
#define R_DIV      1000000.0                       /* R71 (to 3V3_SLEEP) = R72 (to GND) = 1 M */
#define R_SERIES   94000.0                         /* RB1 + RB2 (47 k each) per probe connector */

/* probe node in mV (ADC channel 0 = IO20, 3.2 V reference), -1 if no conversion; as leak_wake.c */
static int leak_mv(void)
{
    struct bflb_device_s *adc = bflb_device_get_by_name("adc");
    struct bflb_adc_config_s cfg = {
        .clk_div = ADC_CLK_DIV_32, .scan_conv_mode = false, .continuous_conv_mode = true,
        .differential_mode = false, .resolution = ADC_RESOLUTION_16B, .vref = ADC_VREF_3P2V,
    };
    struct bflb_adc_channel_s chan = { .pos_chan = ADC_CHANNEL_0, .neg_chan = ADC_CHANNEL_GND };
    uint32_t raw = 0;
    bool got = false;
    bflb_adc_init(adc, &cfg);
    bflb_adc_channel_config(adc, &chan, 1);
    bflb_adc_start_conversion(adc);
    for (int i = 0, waited = 0; !got && waited < 50;) {
        if (bflb_adc_get_count(adc) == 0) {
            bflb_mtimer_delay_ms(1);
            waited++;
            continue;
        }
        raw = bflb_adc_read_raw(adc);
        got = i++ == 5;                            /* the SDK's first results after a start are stale */
    }
    bflb_adc_stop_conversion(adc);
    int mv = -1;
    if (got) {
        struct bflb_adc_result_s r;
        bflb_adc_parse_result(adc, &raw, &r, 1);
        mv = r.millivolt;
    }
    bflb_adc_deinit(adc);
    return mv;
}

/* resistance across a probe connector in kohm (water + nothing else), < 0 = dry (> 20 Mohm) */
static long leak_kohm(int mv)
{
    if (mv <= 0)
        return 0;
    double rx = R_DIV * mv / (V_SLEEP_MV - mv);    /* R72 || probe path */
    if (rx >= R_DIV * 0.98)
        return -1;
    double rp = 1.0 / (1.0 / rx - 1.0 / R_DIV) - R_SERIES;
    return rp > 20e6 ? -1 : (long)(rp / 1000.0 + 0.5);
}
#endif

/* ---------------------------------------------------------------- status ---- */
static void print_status(bool line)
{
    unsigned n = sense_high();
    if (line) {                                    /* pt_mon: one compact line */
        printf("[%lu s]", (unsigned long)(bflb_mtimer_get_time_ms() / 1000));
#if PT_TEST_USB
        printf(" usb=%s", bflb_gpio_read(gpio, PIN_USB_PGOOD) ? "no" : "yes");
#endif
        printf(" pwr=%s 3v3=%u/%u rst=%s", rails_on ? "on" : "off", n, SENSE_ALL, reset_held ? "held" : "run");
#if PT_TEST_LEAK
        int mv = leak_mv();
        long k = leak_kohm(mv);
        printf(" leak=%dmV", mv);
        if (k >= 0)
            printf("/%ldk", k);
#endif
#if PT_TEST_I2C
        int rh, t;
        enum aht20_result r = aht20_read(&rh, &t);
        if (r == AHT20_OK)
            printf(" rh=%d.%d%% t=%d.%dC", rh / 10, rh % 10, t / 10, abs(t % 10));
        else
            printf(" aht20=err");
#endif
#if PT_TEST_UART
        printf(" uart=%s", uart_on ? "on" : "off");
#endif
        printf("\r\n");
        return;
    }
#if PT_TEST_USB
    printf("USB cable   : %s (PGOOD %s)\r\n", bflb_gpio_read(gpio, PIN_USB_PGOOD) ? "not detected" : "detected",
           bflb_gpio_read(gpio, PIN_USB_PGOOD) ? "high" : "low");
#endif
    printf("K230_PWR    : %s\r\n", rails_on ? "HIGH (rails commanded on)" : "low (rails off)");
    printf("K230 reset  : %s\r\n", reset_held ? "held (Q4 on)" : "released");
    printf("K230 BOOT1  : IO27 %s\r\n", boot1_name[boot1]);
    printf("3V3 switched: %s (%u of %u SDIO pull-ups high; K230_ALIVE %s)\r\n",
           n >= SENSE_UP ? "UP" : n == 0 ? "off" : "PARTIAL - check", n, SENSE_ALL,
           bflb_gpio_read(gpio, PIN_K230_ALIVE) ? "high" : "low");
    if (rails_on != (n >= SENSE_UP))
        printf("  FAIL: 3V3 does not follow K230_PWR. Check 0V8 (U6, C18) and 3V3 (U8, C87).\r\n");
#if PT_TEST_LEAK
    int mv = leak_mv();
    long k = leak_kohm(mv);
    if (k < 0)
        printf("Leak probes : %d mV, dry (expected ~1650 mV with nothing across S1..S3)\r\n", mv);
    else
        printf("Leak probes : %d mV, %ld kohm across a probe%s\r\n", mv, k, mv < 825 ? " (WET by the product threshold)" : "");
#endif
#if PT_TEST_I2C
    int rh, t;
    enum aht20_result r = aht20_read(&rh, &t);
    if (r == AHT20_OK)
        printf("AHT20       : %d.%d %%RH, %d.%d C\r\n", rh / 10, rh % 10, t / 10, abs(t % 10));
    else
        printf("AHT20       : FAIL, %s\r\n", aht20_err(r));
#endif
#if PT_TEST_UART
    printf("UART0 link  : %s\r\n", uart_on ? "on, 1 message/s" : "off");
#endif
}

#define LOCKED(code) do { xSemaphoreTake(hw, portMAX_DELAY); code; xSemaphoreGive(hw); } while (0)

static int cmd_status(int argc, char **argv)
{
    LOCKED(print_status(false));
    return 0;
}

static int cmd_mon(int argc, char **argv)
{
    monitor = argc < 2 || strcmp(argv[1], "off") != 0;
    printf("monitor %s\r\n", monitor ? "on (pt_mon off to stop)" : "off");
    return 0;
}
SHELL_CMD_EXPORT_ALIAS(cmd_status, pt_status, board test status);
SHELL_CMD_EXPORT_ALIAS(cmd_mon, pt_mon, one status line per second (pt_mon off));

/* ---------------------------------------------------------------- commands ---- */
#if PT_TEST_POWER
static int cmd_on(int argc, char **argv)
{
    uint32_t t;
    LOCKED(t = rails_on_timed());
    if (t == 0)
        printf("FAIL: 3V3 not up %u ms after K230_PWR (%u of %u lines high); rails switched off.\r\n"
               "  Measure 0V8 at C18 and 3V3 at C87 (power_check.py) and check U6/U8.\r\n",
               RAMP_TIMEOUT_US / 1000, sense_high(), SENSE_ALL);
    else
        printf("OK: 3V3 up %lu.%03lu ms after K230_PWR (expected ~3 ms). K230 held in reset.\r\n"
               "  Now measure 0V8, 3V3, 1V8, 1V1 (power_check.py flashed), then pt_run.\r\n",
               (unsigned long)(t / 1000), (unsigned long)(t % 1000));
    return 0;
}

static int cmd_off(int argc, char **argv)
{
    uint32_t t;
    LOCKED(t = rails_off_timed());
    if (t == 0)
        printf("FAIL: 3V3 still up 1 s after K230_PWR went low: something else feeds it.\r\n");
    else
        printf("OK: 3V3 gone %lu ms after K230_PWR low (expected 56-82 ms through RD1/RD2).\r\n",
               (unsigned long)(t / 1000));
    return 0;
}

static int cmd_run(int argc, char **argv)
{
    if (!rails_on) {
        printf("rails are off: pt_on first\r\n");
        return 0;
    }
    reset_hold(false);
    printf("K230 reset released. With a blank NAND its ROM enumerates on USB-C 1 within ~2 s:\r\n"
           "  lsusb | grep 29f1:0230      (Windows: Device Manager, 'K230 USB Boot Device')\r\n"
           "That proves 0V8, 1V1, 1V8 and 3V3 together. pt_hold puts it back in reset.\r\n");
    return 0;
}

static int cmd_hold(int argc, char **argv)
{
    reset_hold(true);
    printf("K230 held in reset\r\n");
    return 0;
}

static int cmd_cycle(int argc, char **argv)
{
    unsigned n = argc > 1 ? (unsigned)atoi(argv[1]) : 10;
    uint32_t up_min = UINT32_MAX, up_max = 0, dn_min = UINT32_MAX, dn_max = 0;
    for (unsigned i = 0; i < n; i++) {
        uint32_t up, dn;
        LOCKED(up = rails_on_timed());
        if (up == 0) {
            printf("cycle %u: FAIL, 3V3 did not come up\r\n", i + 1);
            return 0;
        }
        vTaskDelay(pdMS_TO_TICKS(200));
        LOCKED(dn = rails_off_timed());
        if (dn == 0) {
            printf("cycle %u: FAIL, 3V3 did not go down\r\n", i + 1);
            return 0;
        }
        up_min = up < up_min ? up : up_min, up_max = up > up_max ? up : up_max;
        dn_min = dn < dn_min ? dn : dn_min, dn_max = dn > dn_max ? dn : dn_max;
    }
    printf("OK: %u cycles, 3V3 up in %lu-%lu us, down in %lu-%lu ms. Rails left off.\r\n", n,
           (unsigned long)up_min, (unsigned long)up_max, (unsigned long)(dn_min / 1000),
           (unsigned long)(dn_max / 1000));
    return 0;
}
SHELL_CMD_EXPORT_ALIAS(cmd_on, pt_on, K230 rails on (reset held) and time the 3V3 ramp);
SHELL_CMD_EXPORT_ALIAS(cmd_off, pt_off, K230 rails off and time the discharge);
SHELL_CMD_EXPORT_ALIAS(cmd_run, pt_run, release K230 reset: blank NAND enumerates as 29f1:0230);
SHELL_CMD_EXPORT_ALIAS(cmd_hold, pt_hold, hold the K230 in reset);
SHELL_CMD_EXPORT_ALIAS(cmd_cycle, pt_cycle, n power cycles with timing (default 10));
#endif

#if PT_TEST_UART
static int cmd_uart(int argc, char **argv)
{
    const char *a = argc > 1 ? argv[1] : "on";
    if (!strcmp(a, "off")) {
        LOCKED(uart_stop());
        printf("UART0 off, link pins parked\r\n");
    } else if (!strcmp(a, "send") && argc > 2) {
        if (!uart_on) {
            printf("UART0 is off: pt_uart on\r\n");
            return 0;
        }
        LOCKED(for (int i = 2; i < argc; i++) { uart_send(argv[i]); uart_send(i + 1 < argc ? " " : "\r\n"); });
        printf("sent\r\n");
    } else {
        bool ok;
        LOCKED(ok = uart_on || uart_start());
        printf(ok ? "UART0 on: IO21 TX -> K230 UART1 RX, IO22 RX <- K230 UART1 TX, 115200 8N1, 1 message/s\r\n"
                  : "3V3 is off: pt_on first (the link pins are pulled up to the K230's 3V3)\r\n");
    }
    return 0;
}
SHELL_CMD_EXPORT_ALIAS(cmd_uart, pt_uart, UART0 link test: on | off | send <text>);
#endif

#if PT_TEST_I2C
static int cmd_i2c(int argc, char **argv)
{
    if (argc > 1 && !strcmp(argv[1], "scan")) {
        struct bflb_device_s *i2c0 = bflb_device_get_by_name("i2c0");
        unsigned found = 0;
        printf("I2C0 scan (IO28 SCL, IO29 SDA, 4.7 k to 3V3_SLEEP):");
        xSemaphoreTake(hw, portMAX_DELAY);
        for (uint16_t a = 0x08; a < 0x78; a++) {
            uint8_t b;
            struct bflb_i2c_msg_s msg = { .addr = a, .flags = I2C_M_READ, .buffer = &b, .length = 1 };
            if (bflb_i2c_transfer(i2c0, &msg, 1) >= 0) {
                printf(" 0x%02x", a);
                found++;
            }
        }
        xSemaphoreGive(hw);
        printf("%s\r\n", found ? "" : " nothing answered");
        printf("expected: 0x38 (AHT20, U17)\r\n");
        return 0;
    }
    int rh, t;
    enum aht20_result r;
    LOCKED(r = aht20_read(&rh, &t));
    if (r == AHT20_OK)
        printf("AHT20 OK: %d.%d %%RH, %d.%d C\r\n", rh / 10, rh % 10, t / 10, abs(t % 10));
    else
        printf("AHT20 FAIL: %s\r\n", aht20_err(r));
    return 0;
}
SHELL_CMD_EXPORT_ALIAS(cmd_i2c, pt_i2c, AHT20 reading or pt_i2c scan);
#endif

#if PT_TEST_USB
static int cmd_usb(int argc, char **argv)
{
    bool pg = bflb_gpio_read(gpio, PIN_USB_PGOOD);
    printf("USB cable on USB-C 1: %s (PGOOD %s; plugging and unplugging is reported as it happens)\r\n",
           pg ? "not detected" : "detected", pg ? "high" : "low");
    return 0;
}
SHELL_CMD_EXPORT_ALIAS(cmd_usb, pt_usb, USB cable detection (PGOOD));
#endif

#if PT_TEST_LEAK
static int cmd_leak(int argc, char **argv)
{
    int mv;
    LOCKED(mv = leak_mv());
    long k = leak_kohm(mv);
    printf("leak node %d mV (dry ~1650, product calls < 825 mV wet = < ~400 kohm water)\r\n", mv);
    if (k < 0)
        printf("  dry: nothing across S1..S3\r\n");
    else
        printf("  %ld kohm across a probe (put a known resistor across S1 to check: 100k reads ~100)\r\n", k);
    return 0;
}
SHELL_CMD_EXPORT_ALIAS(cmd_leak, pt_leak, leak probe node and resistance);
#endif

/* ---------------------------------------------------------------- tasks ---- */
/* CherryUSB's weak hook: a terminal opening the PR1 console raises DTR */
void usbd_cdc_acm_set_dtr(uint8_t busid, uint8_t intf, bool dtr)
{
    (void)busid, (void)intf;
    console_open = dtr;
}

static void background_task(void *arg)
{
    bool shown = false;
#if PT_TEST_USB
    bool pg_last = bflb_gpio_read(gpio, PIN_USB_PGOOD);
#endif
    uint64_t next_s = bflb_mtimer_get_time_ms() + 1000;
    for (;;) {
        if (console_open && !shown) {
            vTaskDelay(pdMS_TO_TICKS(300));
            printf("\r\nLEAKCAM BL616 board test, " __DATE__ " " __TIME__ "\r\n"
                   "commands: pt_status pt_mon pt_boot1"
#if PT_TEST_POWER
                   " pt_on pt_off pt_run pt_hold pt_cycle"
#endif
#if PT_TEST_UART
                   " pt_uart"
#endif
#if PT_TEST_I2C
                   " pt_i2c"
#endif
#if PT_TEST_USB
                   " pt_usb"
#endif
#if PT_TEST_LEAK
                   " pt_leak"
#endif
                   "\r\n\r\n");
            LOCKED(print_status(false));
            shown = true;
        } else if (!console_open) {
            shown = false;
        }
#if PT_TEST_USB
        bool pg = bflb_gpio_read(gpio, PIN_USB_PGOOD);
        if (pg != pg_last) {
            printf("USB cable %s\r\n", pg ? "unplugged (PGOOD high)" : "plugged in (PGOOD low)");
            pg_last = pg;
        }
#endif
#if PT_TEST_UART
        if (uart_on) {
            int c;
            char buf[64];
            unsigned n = 0;
            while (n < sizeof(buf) - 1 && (c = bflb_uart_getchar(uart0)) >= 0)
                buf[n++] = (char)c;
            if (n) {
                buf[n] = 0;
                printf("uart rx: %s\r\n", buf);
            }
        }
#endif
        if (bflb_mtimer_get_time_ms() >= next_s) {
            next_s += 1000;
#if PT_TEST_UART
            if (uart_on) {
                char msg[64];
                snprintf(msg, sizeof(msg), "LEAKCAM BL616 uart test %u, %lu ms\r\n", ++uart_count,
                         (unsigned long)bflb_mtimer_get_time_ms());
                LOCKED(uart_send(msg));
            }
#endif
            if (monitor)
                LOCKED(print_status(true));
        }
        vTaskDelay(pdMS_TO_TICKS(20));
    }
}

static void boot1_set(enum boot1_mode m)
{
    if (m == BOOT1_PARK) {
        park(PIN_BOOT1_FORCE);
    } else {
        bflb_gpio_init(gpio, PIN_BOOT1_FORCE, GPIO_OUTPUT | GPIO_FLOAT | GPIO_DRV_0);
        if (m == BOOT1_HIGH)
            bflb_gpio_set(gpio, PIN_BOOT1_FORCE);
        else
            bflb_gpio_reset(gpio, PIN_BOOT1_FORCE);
    }
    boot1 = m;
}

static int cmd_boot1(int argc, char **argv)
{
    if (argc > 1) {
        if (!strcmp(argv[1], "low"))
            boot1_set(BOOT1_LOW);
        else if (!strcmp(argv[1], "high"))
            boot1_set(BOOT1_HIGH);
        else if (!strcmp(argv[1], "park"))
            boot1_set(BOOT1_PARK);
        else {
            printf("usage: pt_boot1 low|high|park\r\n");
            return -1;
        }
    }
    printf("K230 BOOT1  : IO27 %s; the ROM reads it at reset (pt_hold, pt_run)\r\n", boot1_name[boot1]);
    return 0;
}
SHELL_CMD_EXPORT_ALIAS(cmd_boot1, pt_boot1, K230 BOOT1 strap: low | high | park);

static void pins_init(void)
{
    gpio = bflb_device_get_by_name("gpio");
    /* reset asserted before K230_PWR becomes an output, rails off (as k230_power.c) */
    bflb_gpio_init(gpio, PIN_K230_RSTN, GPIO_OUTPUT | GPIO_FLOAT | GPIO_SMT_EN | GPIO_DRV_0);
    reset_hold(true);
    bflb_gpio_init(gpio, PIN_K230_PWR, GPIO_OUTPUT | GPIO_FLOAT | GPIO_SMT_EN | GPIO_DRV_0);
    bflb_gpio_reset(gpio, PIN_K230_PWR);
    bflb_gpio_init(gpio, PIN_K230_ALIVE, GPIO_INPUT | GPIO_FLOAT | GPIO_SMT_EN);
    bflb_gpio_init(gpio, PIN_USB_PGOOD, GPIO_INPUT | GPIO_FLOAT | GPIO_SMT_EN);
    park(PIN_LINK_TX);
    park(PIN_LINK_RX);
    park(PIN_SD_CLK);
    boot1_set(BOOT1_LOW);
    park(PIN_LEAK_SENS);           /* 1.65 V dry: between VIL and VIH, analog only */
    for (unsigned i = 0; i < SENSE_ALL; i++)
        bflb_gpio_init(gpio, sense_pins[i], GPIO_INPUT | GPIO_FLOAT | GPIO_SMT_EN);
#if PT_TEST_UART
    uart0 = bflb_device_get_by_name("uart0");
#endif
#if PT_TEST_I2C
    aht20_init();
#endif
}

int main(void)
{
    board_init();          /* also starts the USB CDC console and its shell (defconfig) */
    pins_init();
    hw = xSemaphoreCreateMutex();
    xTaskCreate(background_task, "pt", 2048, NULL, 2, NULL);
    vTaskStartScheduler();
    while (1) {
    }
}
