vkorehov/LEAKCAM/(commit log)

2026-09-07 power DDR
2026-09-07 Switch stackup to JLCPCB default 6-layer 1.6mm (No Requirement)
    Top 1oz / PP3313 0.0994 / L2 0.5oz / core 0.55 / L3 0.5oz / PP2116 0.1164 /
    L4 0.5oz / core 0.55 / L5 0.5oz / PP3313 0.0994 / Bottom 1oz.
    Dk 4.1 (3313), 4.16 (2116), 4.6 (core); mask 1.2mil Dk 3.8 unchanged.
    Replaces the 4-layer JLC04161H-7628 stack; enables OSP + via-in-pad 6L offer.
2026-09-07 Stackup: use 2.4 GHz dielectric constants
    Standard TG135 FR-4 at 2.4 GHz instead of 1 GHz catalogue values:
    PP-3313 Dk 3.95, PP-2116 Dk 4.00, 0.55 mm core Dk 4.40, all Df 0.022;
    LPI solder mask Dk 3.50, Df 0.025. Engineering estimates, sweep +/-0.15 in CST.
2026-09-09 power
    power
2026-09-09 seonsors
    sensors
2026-09-10 Stackup: match JLC06161H-3313 (2116 prepreg 0.1088 mm, solder mask Dk 3.8)
    Core Dk stays 4.4 and prepregs 3.95/4.0 as 2.4 GHz values.
2026-09-11 LAYERS.txt: document 6-layer stack, copper layer assignment and gerber order
    JLC06161H-3313, 1.6 mm. GND planes on L2 and L6, power on L1 and L4,
    signal on L3 and L5. Records the gerber file order (G1..G4 = Mid-Layer
    1..4 in physical order) and the Altium/JLCPCB output settings.
2026-09-14 LAYERS.txt: record the layer usage as actually routed (power pours on L3, signal on L5)
2026-09-14 MIFA.PcbDoc: HoleSize rule min 11 mil (0.28 mm) so 0.2 mm footprint vias fail DRC
    Routing Via Style does not check component-embedded vias; the Manufacturing
    HoleSize rule does. Same-size in-place edit of the Rules6 record.
2026-09-14 MIFA.PcbDoc: U14/U15 thermal vias 0.2 -> 0.3 mm hole (DRV0006A_V vault footprint)
    In-place edit of the four Vias6 records; pad diameter 0.5 mm unchanged.
2026-09-14 LAYERS.txt: gerber file names as generated (MIFA.*, GM/GM2, RoundHoles/SlotHoles)
2026-09-14 fix usb and currents
2026-09-15 BOM_LCSC.xlsx: cheapest in-stock LCSC part per BOM line, 5 boards, with links
2026-09-15 BOM_LCSC.xlsx: re-priced for a single board
2026-09-15 Unify duplicate capacitor comments (C96 -> 10uF GRM188R61A106ME69D, C1 -> 1uF 50V 1206); BOM re-priced
    In-place edits of the Comment parameter records; hidden Weight/Thickness/Depth
    texts of C96 shortened to keep the record stream the same length.
2026-09-15 Merge near-duplicate BOM lines in the schematic; order list with LCSC column
    C96 10uF 0603 -> 10uF GRM188R61A106ME69D, C1 -> 1uF 50V 1206,
    R71/R72 510k -> 511k, C22 100pF -> 120pF, C98 15pF -> 20pF.
    In-place Comment edits; C96 hidden Weight/Thickness/Depth texts shortened
    to keep the record stream length. BOM re-priced for one board.
2026-09-15 Schematic: LCSC part number in every component Description (219 parts)
    Written with the new compound-file rewriter, so record lengths could change;
    C96's hidden Weight/Thickness/Depth texts restored to their original values.
    J4/J5 carry the HanElectricity 05B20L22P substitute because Molex 54548-2271
    is discontinued; verify its footprint before ordering.
2026-09-15 Schematic: align %UTF8%ComponentDescription with the LCSC number too
    Altium keeps a UTF-8 copy of the Description when it contained non-ASCII
    text (Ω, µ); that copy is what it displays, so it must carry the C-number as well.
2026-09-15 BOM re-sourced for stock: passives moved to >=1000-piece LCSC parts (25 lines, +0.03 USD)
    The cheapest-total run had left 20 passive lines on stocks of 1 to 55 pieces.
    Re-priced with --min-stock 1000 --pages 4: every R/C now has 1.3k to 3.5M in
    stock; total 43.62 -> 43.65 USD for one board. Schematic ComponentDescription
    (and %UTF8% copy) updated on 94 designators to the new C-numbers.
    Still below 1000 (single-source, no alternative): K230D 361, Ai-M62-CBS 211,
    BQ24072 387, TPS61160A 36, JST SM05B 984.
    Adds BOM_JLCPCB.csv (Comment/Designator/Footprint/LCSC Part # for the
    assembly BOM upload) and JLCPCB_parts_cart.csv (C-number,qty for the parts
    cart bulk add).
2026-09-15 BOM re-sourced for stock: passives moved to >=1000-piece LCSC parts (25 lines, +0.03 USD)
    cart bulk add).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
2026-09-15 tools/jlcpcb-cart: add the LCSC order list to the JLCPCB parts cart via your own Chromium
    JLCPCB has no public API for the parts cart, so the script attaches to a
    Chromium started with --remote-debugging-port=9222 (puppeteer-core over CDP),
    records the add-to-cart request while you add C15849 x7 by hand once, and
    replays it for every "C-number,qty" row of JLCPCB_parts_cart.csv from inside
    the page, so cookies and any token headers are the real session's.
    cart_api.json (the captured request) and node_modules are gitignored.
2026-09-15 Schematic + BOM follow the LCSC-orderable parts (9 lines, 48 designators)
    lcsc.com does not sell or has no stock of nine JLCPCB-library picks; the
    substitutes verified in the LCSC cart are now the schematic's LCSC numbers:
    DSK24 C51898076 -> C2939005 KUU DSK24 (SOD-123FL 40V 2A)
    10k 0402 C22369472 -> C1858459 YAGEO RC0402FR-1310KL
    200k 0402 C22369550 -> C102872 RALEC RTT022003FTH
    240R 0402 C22356255 -> C324768 RC-02K2400FT
    5.1k 0402 C22369457 -> C103079 RALEC RTT025101FTH
    100n 0402 C3012377 -> C513772 Samwha CS1005X7R104K500NR 50V X7R
    120p 0402 C7507400 -> C2887023 CCTC TCC0402COG121J500AT
    1k ferrite C76883 -> C280602 Chil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
2026-09-15 changed connector
2026-09-16 Use JLCPCB Basic parts where they meet the spec (26 lines); full Basic parts list added
    JLCPCB_BASIC_PARTS.txt: all 351 Basic parts from the parts API (no loading fee).
    Switched: 18 passive lines (exact value/package/voltage/tolerance match),
    FB1-3 -> BLM18PG121SN1D, Q1 -> AO3401A, Q2/Q4 -> AO3400A, Y1/Y3 -> Q13FC13500004.
    Value changes: R25 33.2k -> 33k (0V8 rail -1 mV), R21 46.4k -> 47k (charge
    timer 6.2 -> 6.3 h). Schematic Description = new C-number, Comment updated
    where the MPN or value changed; all order lists follow.
2026-09-16 220n COMP caps and Cff caps to Basic parts (C16772 16V X7R, C1546 100pF C0G)
    TPS61160A datasheet: COMP = 220nF, pin below 3V so 16V is fine.
    TPS62823 Cff = 12ms/R2 -> 120pF (0V8, R2=100k) and 100pF (1V1, R2=120k);
    both now 100pF, within loop tolerance.
2026-09-16 D1 charge LED -> Basic red 0603 KT-0603R (C2286); footprint 0402 -> 0603 to be changed in the library
2026-09-16 Revert "D1 charge LED -> Basic red 0603 KT-0603R (C2286); footprint 0402 -> 0603 to be changed in the library"
    This reverts commit ce13db8fbb8fb8dcc5b02b97936a9742eb360d52.
2026-09-16 Resistors moved to Basic values where the circuit allows; order lists regenerated from the schematic
    R5 ILIM 1.1k->1.5k (input limit 1.41->1.03 A), R7 ISET 590R->1k (charge 1.51->0.89 A),
    R8 EN2 pull-up 150k->100k, R56/R69 1V8 divider 261k/100k->51k/20k (1.805->1.775 V),
    R71/R72 leak divider 511k->1M (less standby current), R66 IR Rset 4.02->4.7 ohm (50->43 mA),
    R29 120k to the Basic part. Kept Extended: 240R x4 (DDR ZQ/VREF must be 240), R63 30k
    (K230 USB VBUS sense, as on the EVB), 511k/91k for both TPS63802 3.3 V dividers
    (Basic ratios would cost +17 uA on the always-on rail). FB4 and D1 Descriptions
    set to the C-numbers of the Basic parts the user placed.
    Order lists now come from bom_fr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
2026-09-16 Apply the resistor/Basic changes announced in 6e6a6a1 (map generation had failed); 120k has no Basic part and stays Extended
2026-09-16 Charger back to ILIM 1.1k (1.41 A) and ISET 590R (1.51 A) per user; Basic values not worth the slower charge
2026-09-16 Charger limits to Basic values: ILIM 1.5k (1.03 A), ISET 1k (0.89 A)
2026-09-16 Fee-free parts: Promotional Extended included; DSK24 -> promo C22466352, R29 120k -> promo, R22/R50 511k -> 510k promo (3.302 V), C1/C104 -> Basic CL31B105KBHNNNE
    JLCPCB_ECONOMIC_PARTS.txt replaces JLCPCB_BASIC_PARTS.txt: all 1586 Basic + Promotional
    Extended parts ($0 feeder loading in Economic PCBA), fetched with
    componentLibraryType=base + preferredComponentFlag=true + searchType=2.
    Order lists label Basic / Promo / Extended.
2026-09-16 Pick-and-place Comment/Description columns refreshed from the schematic (refresh_pnp.py); coordinates untouched
2026-09-16 U17: AHT30 out of stock, use AHT20 (same 3x3 mm 6-pad package, same pinout and I2C protocol, C2757850)
2026-09-16 U14/U15: TPS61160ADRVT (36 in stock, 1.11 USD) -> TPS61160DRVR (11.6k in stock, 0.45 USD); same WSON-6, 200 mV FB, 26 V OVP, 600 kHz
2026-09-16 Fabrication package: LEAKCAM_gerber.zip (6 copper, mask, silk, paste, clean GKO outline, round and slot drills) and LEAKCAM_assembly.zip (pick-and-place, BOM CSV, cart CSV, order list)
    MIFA.GKO is a plain 36.5 x 65 mm rectangle from the ODB++ profile; the Altium mechanical layers GM/GM2 also carry small footprint shapes that a fab could read as cutouts, so they are not in the zip.
2026-09-16 Assembly BOM without the hand-soldered connectors (BOM_JLCPCB_SMT.csv) and DNP list; assembly zip updated
2026-09-16 cart tool: detect the passport.jlcpcb.com SSO page as not-logged-in; Extended-parts cart list for 2 boards
2026-09-16 Assembly: only the JST through-hole connectors are hand-soldered; USB-C, SH and FPC connectors go on the machine
2026-09-16 Assembly zip: one BOM only (BOM_JLCPCB_SMT.csv), pick-and-place and DNP note
2026-09-16 Assembly files: PickPlace_MIFA.csv (JLCPCB format, mm, non-placed parts removed) + BOM_JLCPCB_SMT.csv; zip dropped
2026-09-16 Rename assembly BOM to BOM_ASSEMBLY.csv
2026-09-16 Regenerate fabrication and assembly files from the 19:15 export
    Gerber zip: 6 copper, mask, silk, paste, MIFA.GKO (36.5 x 65 mm rectangle from the
    ODB++ profile; GM/GM2/GM5 carry footprint mechanical shapes besides the outline),
    round and slot drills (slot file verified against the board: all 8 USB-C slots match).
    PickPlace_MIFA.csv and BOM_ASSEMBLY.csv are generated from Project Outputs/Pick Place
    for MIFA.csv and cross-checked against the schematic (0 mismatches) and the ODB++
    (positions and sides); 215 placements, 55 part numbers, same designator set in both.
    PR1 is now programming pads, not a connector, so it has no part. Order lists refreshed:
    41.17 USD per board.
2026-09-16 Regenerate fabrication and assembly files from the 21:49 export
    Gerber zip now uses Altium's own MIFA.GKO (board outline plus the four 0.6 mm USB
    peg cutouts). Drill files carry a non-plated section: 0.5 mm acoustic port under
    U13 and the 2.6 mm mounting hole. PickPlace_MIFA.csv and BOM_ASSEMBLY.csv
    regenerated, cross-checked against the schematic and the ODB++, 215 placements.
2026-09-16 Gerber zip: clean board outline, USB peg cutouts drilled instead of milled
    The outline gerber is written from the ODB++ profile, so it holds the 36.5 x 65 mm
    board edge and nothing else. The four 0.6 mm USB connector peg openings, which Altium
    put on the keep-out layer as internal cutouts, are added to the non-plated drill file
    as tool T07: a router bit is 1.0 mm, so they could not be milled at that size.
2026-09-16 Gerber zip: drill files exactly as exported; the four USB peg cutouts stay on the outline layer and are reported instead of patched into the drill file
2026-09-16 Fabrication and assembly files from the 22:42 export
    USB locating posts are now drilled: T06, 0.6 mm, non-plated, four holes; the keep-out
    layer carries only the board edge, so the outline gerber needs nothing but the profile.
    Drill files in the zip are byte-identical to the export. 215 placements, 55 part numbers,
    cross-checks against schematic and board clean.
2026-09-17 Fabrication and assembly package from the 05:46 export
2026-09-17 Fabrication and assembly notes for the order
2026-09-17 FAB_NOTES.txt: cut to the essentials
2026-09-17 LCSC order for one hand-built board: 55 lines in the cart, 20% spare on cheap passives
    U16 NAND -> C17626844, the other LCSC code for W25N02KVZEIR: it has single-piece
    marketplace offers at 8.98 USD, while C3010298 is LCSC-own only with an 8-piece
    minimum (92.68 USD). C86 1uF 0603 -> C696901 (C15849 out of stock at LCSC).
    FB4 -> BLM18PG121SN1D, same 0603 part as FB1-FB3 (GZ1608D601TF is not sold by
    lcsc.com); 120 ohm instead of 600 ohm on the microphone bias filter.
    Cart total about 53.80 USD. Cart script parks the tab on a stable page and retries
    when lcsc.com navigates under it; the launcher takes a URL.
2026-09-21 Fabrication and assembly package from the 18:54 export (FB4 on the 0603 land, inner ground extended to the antenna edge)
2026-09-22 FIXED antenna!!
2026-09-22 Fabrication and assembly package from the 22 Sep 16:04 export (antenna redesigned for the inner ground reference)
2026-09-22 Fabrication and assembly package from the 22 Sep 16:43 export (SOD-123FL land for the Schottky diodes)
2026-09-22 EXTERNAL_PARTS.md: off-board parts (battery, NTC, camera modules, adapter cable) with the hardware they actually are
2026-09-22 EXTERNAL_PARTS.md: three more camera cables ordered, standard-lens OV5647 for bring-up
2026-09-22 mechanical/camera: STEP model of the OV5647 wide-angle Pi camera board for antenna placement studies
2026-09-23 Fabrication and assembly package from the 23 Sep 08:01 export (antenna element trimmed)
2026-09-23 EXTERNAL_PARTS.md: battery solders to JB1/JB2, S1-S3 are the leak-probe inputs
2026-09-23 firmware: K230 power-sequence model and BL616/K230 power-management PoC
    sim/power_sequence.py models the EN/PG chain with TPS62823/TPS63802 datasheet timings.
    Cold start meets the K230 guide; after power-off 1V8/3V3 (no discharge) outlive the 0V8
    core by 0.6-3.7 s, so a restart must wait or 0V8 comes up last.
    bl616_pwrmgr: sequenced power-up with reset held, 5 s minimum off-time, K230-side pins
    parked while 3V3 is off (the 10 k pull-ups go to the switched rail), leak wake from HBN
    via ACOMP1 on GPIO20, heartbeat watchdog with reset-first recovery, console on USB CDC.
    k230_agent: heartbeat on GPIO2, UART1 protocol, sync and read-only remount before HALTED.
2026-09-23 firmware: USB-powered BLE mode for Wi-Fi credential setup, PGOOD wake via ACOMP0
    A USB plug must wake the BL616 from HBN. PGOOD is on IO27 (ADC_CH10), which is neither an
    HBN wake pin nor comparator-capable (ACOMP selects ADC_CH0-7). Firmware targets the next spin:
    PGOOD on IO03 (ADC_CH3, ACOMP0), K230_PWR on IO30.
    On USB power the BL616 stays awake, advertises LEAKCAM-xxyy and accepts pairing only while
    PGOOD is low; one service writes SSID/passphrase into easyflash. Unplug reboots into the
    battery path without a K230 session. Also adds CMakeLists.txt and the simulation report,
    which the root *.txt ignore rule had kept out of the previous commit.
2026-09-23 firmware: periodic AHT20 humidity sampling on RTC wake, humidity alarm session
    The AHT20 has no interrupt pin, so humidity is read on HBN RTC wake-ups every 10 min over
    I2C0 (IO28 SCL, IO29 SDA, 0x38, 100 kHz); the K230 stays off unless RH >= 85 % (re-armed
    below 75 %). The K230's sleep interval is served in these slices, counted in the HBN status
    register. Each session sends ENV,<rh_x10>,<t_x10>, exported to the hook as LEAKCAM_RH/_T.
    RTC runs from the Y3 crystal. Host test checks CRC and conversions against the datasheet.
    README: the two hardware changes (PGOOD/K230_PWR swap, AHT20 VDD RC filter) are listed as
    changes before the first fab, not a respin.
2026-09-23 firmware README: AHT20 VDD filter uses 240 ohm (existing BOM line) with 10 uF
2026-09-23 LED drive for 4 white + 4 IR per side: R66/R68 5.6 ohm (C322191, same 0603 footprint)
    One series string of 8 LEDs per camera side: 35.7 mA, 18.2 V typ / 21.0 V max, switch peak
    0.48 A at a 3.0 V battery (TPS61160 limit 0.56 A min, OVP 37 V min). R66 was 4.7 ohm, which
    would hit the current limit on a low battery; R68 was 10 ohm, half the light on that side.
    LED_RING.md: ring board parts (C385305 white, C385305/C53191414 in SMD2835), counts, mounting.
    Buy list includes both rings.
2026-09-23 LED strips: separate white and IR chains, domed 3535 LEDs, R66 6.8 ohm
    Four 36 x 6 mm strips (2 white + 2 IR each), panelled with the main board and cut by hand.
    White chain on U14/J1, IR chain on U15/J2, so they switch and dim independently.
    R66 6.8 ohm (C23214, same 0603 footprint): 29.4 mA keeps eight white LEDs inside the TPS61160
    switch current limit on a low battery. R68 stays 5.6 ohm (IR 35.7 mA).
    LEDs: Xinglight XL-HD3535UWC-A2 (C3646951, 2.00 mm) and JNJ JNJ-LTJI0112W120 850 nm
    (C19185834, 2.10 mm), domed so the lens stands out through the printed cover; one shared
    3-pad footprint.
    LED_STRIPS.txt replaces LED_RING.md: topology, electrical limits, parts and alternatives,
    footprint, m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
2026-09-23 LED drive at maximum current: R66 3.0 ohm (white 66.7 mA), R68 1.5 ohm (IR 133 mA)
    Targets sit at the TPS61160 switch current limit on a typical unit with a nominal battery
    (datasheet Eq. 3/4: white 60-69 mA, IR 127-156 mA over 3.3-4.2 V); above that the driver runs
    in cycle-by-cycle current limit, far below OVP. PWM duty backs the current off where needed.
    C23157 / C22769, UNI-ROYAL 0603 1 %, same FP-SR0603-MFG footprint.
    LED_STRIPS.txt: electrical limits per corner, component stress, battery load, brightness at 2 m.
2026-09-23 LED drivers U14/U15: TPS61161DRVR (C324075, 38 V OVP) instead of TPS61160DRVR
    The TPS61160 trips open-LED protection at 25-27 V; the eight-white chain runs at 22-26 V.
    TPS61161 is the same WSON-6 2x2 part with 38 V OVP: same pinout and footprint, netlist unchanged.
    Order lists regenerated from the schematic (new LED strip parts, probe and filter resistors);
    LCSC cart covers RB1-RB6 47k and RD1/RD2 1.5k. LED_STRIPS.txt corrected.
2026-09-24 CT1 not fitted; fab zip for the 61 x 65 mm panel; assembly BOM and CPL from the schematic
    CT1 (antenna feed shunt pad): comment NF, no part number, left out of BOM and CPL.
    LEAKCAM_gerber.zip rebuilt from the 2026-09-24 outputs, outline 61.00 x 65.00 mm from the
    ODB++ profile, no small cutouts on the outline layer.
    BOM_ASSEMBLY.csv built from the schematic (U14/U15 TPS61161DRVR C324075, not the stale
    PCB export); its 242 designators match PickPlace_MIFA.csv one to one. Order lists regenerated.
    LCSC hand-build cart: 100 nF 0402 50 V X7R as C131394 (C307331 has 100 pcs left at LCSC).
2026-09-24 firmware/k230_capture: dual-camera capture, change detection and NAND image history (Linux PoC)
    leakcam_capture: both OV5647 over vvcam V4L2, white and IR LED chains with separate PWM
    brightness, 320x240 block comparison against the last wake and a baseline.
    history.c: keyframe + changed-block deltas per camera on the SPI NAND (zlib, CRC, atomic
    writes, 96-delta groups, per-camera quota); leakcam_hist lists and rebuilds stored frames.
    Host tests for the detector and the history.
2026-09-24 k230_capture: RT-Smart build next to Linux (MPP VICAP, /dev/pwm, bundled miniz)
    cap.h / led.h split the platform parts; vicap_cap.c captures both OV5647 through the MPP VICAP
    API (1280x960 binned modes on CSI0 and CSI2, offline mode, one NV12 frame each), led_rtsmart.c
    drives PWM0/PWM1 through /dev/pwm. The RT-Smart SDK has no zlib for user apps, so the history
    uses miniz 3.0.2 there (vendored unmodified, MIT).
    Reference files now use two slots with a generation counter: UFFS cannot rename onto an existing
    file, and a power cut still leaves the newest valid copy. Tests cover slot choice and a torn
    newest slot; the history tests also run with miniz.
    rtsmart/: k230_rtos_sdk application Makefil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
2026-09-24 BL616 keeps the wall clock across hibernate; session flags no longer lost at every sleep
    The session flags were stored with HBN_Set_Status_Flag() = HBN_RSV0, which pm_hbn_mode_enter()
    overwrites with HBN_STATUS_ENTER_FLAG on the way into hibernate. Flags and a wall clock now live
    in the last 64 bytes of HBN RAM (retention enabled before sleep, magic + CRC-32).
    Wall clock: HBN RTC counter on the Y3 crystal plus a (Unix seconds, count) reference, rebased at
    every boot across the 40-bit wrap; invalid after a power loss until real time arrives.
    Link: TIME,<unix s> both ways. The BL616 sends it after WAKE when valid; the agent sets the
    system clock from it and sends TIME back once NTP-synchronise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
2026-09-24 LEAKCAM board port for k230_rtos_sdk: SPI NAND direct boot, RT-Smart only
    k230_board/: the board as a k230_rtos_sdk target, installed by install.sh.
    - pins.py: one pin table, generates the RT-Smart pin mux and the U-Boot pin dtsi. All banks
    3.3 V except the fixed 1.8 V IO0/IO1; check_pad_voltage.py decodes the pad registers from the
    built SPL/U-Boot device trees (64/64 OK; Canaan's prebuilt EVB SPI-NAND SPL: 50 wrong).
    - SPL and U-Boot from source with the LEAKCAM device tree (W25N02KV quad on OSPI, 128 MiB).
    - One image layout: ROM -> SPL -> OpenSBI + RT-Smart through the TOC at 0xe0000, slots
    rtt_a/rtt_b with ota_meta, U-Boot only as the SPL fallback. UFFS /bin and /sdcard with the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
2026-09-24 leakcam_stream (RTSP H.264 + HTTP JPEG/MJPEG) and leakcam_audio (mic to WAV) on RT-Smart
    leakcam_stream: both cameras, VICAP NV12 dumped once and fed to a H.264 channel (RTSP
    cam0/cam1 on 8554 through the SDK's live555 server, 1500 kbit/s, IDR on every new client) and on
    demand to a JPEG channel (HTTP /snap/N.jpg, /mjpeg/N on 8080). Four VENC channels, one VICAP
    channel per camera.
    leakcam_audio: inner codec, left input (MICPL, U13), 16 kHz mono WAV to /sdcard/leakcam with a
    per-second level meter; gains set after the codec's first enable resets them.
    Both build and link in the LEAKCAM image. MIC_BIAS default voltage is undocumented: measure
    at C96 first.
2026-09-24 Wi-Fi over SDIO: BL616 NetHub bridge and the K230 RT-Smart driver
    BL616 (firmware/bl616_wifi): NetHub on the SDIO profile as an Ethernet bridge of its station.
    Only EAPOL stays on the BL616, every other frame goes to the K230, which owns the IP address
    (DHCP, DNS, NTP, sockets in lwIP). Joins with the BLE-provisioned credentials, use_dhcp = 0.
    Control messages (status, join, leave, scan) on the USER virtual channel, defined once in
    wifi_ctrl_proto.h for both sides. Links into leakcam_wifi_bl616.bin.
    K230 (k230_board/rtsmart/drivers/bl616_nethub): SDU transport for 424c:0606 (card-ready
    handshake, 4 ports per direction, fixed-address CMD53 in 512-byte blocks), the message router
    with HOST_RE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
2026-09-24 k230_nn: leakcam model on the KPU, change-network proposal, image-quality signals
    The leakcam leak model (U-Net + inoperational branch, 90x160x4 stack) converts to a 275 KB
    nncase 2.11 kmodel that matches TF in the K230 simulator (severity within 0.008, alarm and
    inoperational decisions identical on 28 pairs). Its weights come from the Pi camera and need a
    LEAKCAM dataset and a retrain; no kmodel is committed.
    Change network: MobileNetV2-0.35 feature maps at stride 16, compared per cell against a stored
    reference embedding; untrained it already beats the pixel metric (69 % vs 47 % of wet pairs, no
    lighting false alarms); int16 quantisation needed.
    k230_capture/imgqual.[ch]: exposure, clippin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
2026-09-24 K230 kernel: hardware RTC (PMU) instead of the soft RTC
    RT_USING_RTC_PMU on the K230's 32.768 kHz crystal; BOARD_NOT_SUPPORT_HW_RTC dropped, so the pin
    mux has 72 entries (PMU pads IO64-IO71 as GPIO). The RTC supply is the switched 1V8 rail, so the
    time is set from the BL616's TIME frame at every boot. Image builds; SPL/U-Boot pads 64/64 OK.
2026-09-24 DESIGN.md: decisions and design in one place; time rides in the WAKE frame
    DESIGN.md: ground rules, system architecture, hardware decisions with reasons, K230 boot and
    system software, firmware behaviour (wake sequence, power manager, BLE, link and time, Wi-Fi,
    imaging pipeline, streaming, audio), rev 1 changes checked against the schematic, open work and
    first-board checks. Links the detailed documents.
    Link: the BL616 answers READY with WAKE,<reason>,<unix s> (0 = its clock is not valid) instead of
    a separate TIME frame; TIME stays K230 -> BL616 for NTP time. Agent, BL616 and link test updated;
    agent builds with -Werror, BL616 firmware links, host tests pass.
    firmware/README.md: the two s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
2026-09-24 DESIGN.md: LED connector polarity re-checked; fab outputs already carry the earlier changes
2026-09-24 DESIGN.md: LED strip connectors already agree (+ on pin 2); IR EasyEDA pad numbering note
2026-09-24 DESIGN.md: LED polarity settled, silkscreen marks every LED
2026-09-24 Fab package from the 2026-09-24 22:48 outputs: gerbers, JLCPCB BOM and CPL
    LEAKCAM_gerber.zip: all copper, mask, silk, paste and both drill files byte-identical to the
    Altium export; outline 61.00 x 65.00 mm from the ODB++ profile, no cutouts on it.
    BOM_ASSEMBLY.csv / PickPlace_MIFA.csv: 244 placements, 56 part numbers, 0 mismatches against the
    schematic and the ODB++ board; S1-S3 hand-soldered. New: CB1 10 uF, CB2 100 nF on MIC_BIAS.
    Order lists regenerated from the schematic with JLCPCB stock (lowest: U11 216, U3 340, U1 356,
    IR LEDs 438; all cover a board).
    FAB_NOTES: the mic acoustic port moved with U13, now X57.566 Y2.563.
    DESIGN.md: MIC_BIAS caps and PR1 pad 6 done; C97/C101 move stays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
2026-09-24 C86 1 uF 0603: C696901 (Extended) -> C15849 (Basic), saves a loading fee
    Same 0603 package (FP-GRM188: 1.6 x 0.8 mm; CL10A105KB8NNNC 1.6 x 0.8 x 0.8 mm), 50 V X5R
    instead of 16 V, on 3V3. Description set in FLASH.SchDoc; the pick-and-place CSV's Comment/
    Description re-synced from the sheets (coordinates untouched) until the next PCB update;
    BOM_ASSEMBLY, CPL and order lists regenerated, 0 mismatches against sheets and board.
    R22/R50 511k stay: the only fee-free 510k (C11616) has a JLCPCB minimum order of 2006 pcs,
    which costs more than the fee it saves.
2026-09-24 Drive strength from the layout audit: OSPI ds 15 -> 7, BL616 SDIO pads DRV_1 -> DRV_0
    OSPI (IO14-19): 12-20 mm traces, no room for series resistors at the balls; SPI_CLK keeps R42.
    Built SPL/U-Boot device tree decodes to DS 7 on all six pads, pad voltages still 64/64 OK.
    BL616 SDIO (GPIO10-15): DRV_0 (9.7/11.4 mA at the 10 % VOH/VOL limit, about 35 ohm) is close to
    the ~49 ohm, 35-52 mm traces; the SDK's DRV_1 is about 11 ohm. Re-applied after every SDK call
    that muxes the pads (nethub bootstrap, low-power restore). bl616_wifi builds.
    K230 MMC0 PHY pads stay at Canaan's values: their code scale is undocumented.
2026-09-25 fix ground
2026-09-25 Schematic: Value and Capacitance/Resistance/Inductance parameters match the Comment
    The library parameters CST reads through the ODB++ export carried vault values: every resistor
    Resistance 768kR (R66/R68 10 ohm), 100n 0201 caps 22 nF, 20p/12p/100pf caps 100 nF, 220n caps
    100 nF. All 192 resistors, capacitors and inductors now carry the Comment's value in Value and in
    their type parameter: 5.1kOhm, 100nF, 0.47uH (ASCII: the ODB++ export turns the ohm sign into
    '?'). Inductor values from the MPN (DFE201612E-R47M 0.47 uH, DFE252012F-100M 10 uH). CT1 (NF)
    untouched. Netlists identical, Comment/Description unchanged, so BOM and CPL are unaffected.
2026-09-25 Fab package from the 07:06 export: R54 at the K230 end, ground returns fixed
    Gerber zip: all 14 Altium files byte-identical, outline 61.00 x 65.00 mm from the ODB++ profile.
    BOM_ASSEMBLY / CPL: 245 placements, 56 part numbers (R54 22R shares C25092 with R42), 0 mismatches
    against sheets and board. Order lists regenerated with JLCPCB stock.
    Layout review (ODB++): no reference gaps on the SDIO clock or SPI_IO0/USB, every SDIO via within
    1 mm of a GND via except D1/D2 at the K230 (1.8 mm), 403 GND vias, no plane point more than 5 mm
    from one; worst estimated reflection 0.7 % (SDIO) / 3 % (MIPI), crosstalk 38 mV.
2026-09-25 K230-BL616 link: sequence numbers, ACK/NAK for every command, resends
    Frames are $<seq>,<CMD>[,args]*XX. Every command is answered ACK,<seq> (accepted) or NAK,<seq>
    (refused: TIME before 2026 on the BL616, ENV out of the AHT20 range on the K230). One command
    in flight per side, resent after 300 ms without an answer, given up after 5 sends; a NAK ends
    it at once. Corrupted frames get no answer (their seq cannot be trusted), the timeout covers
    them. A receiver re-answers a repeat without acting on it twice. READY restarts both sequence
    states unless it repeats the READY just accepted.
    BL616: link_send_cmd()/link_service() drive the resends from every wait loop, TIME is carried
    out in the verdi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
2026-09-25 Host tests for the Wi-Fi driver, wifi_link, imgqual and leakcam_audio; three driver fixes
    bl616_nethub/test: the three driver sources built unchanged against RT-Thread stand-ins, worker
    in lockstep on a virtual clock, a simulated BL616 SDU that flags protocol mistakes. Covers
    probe and attach (OUT_PTR 0x00/0x21/0x33, ring wrap), HOST_READY resend, wlan0 with the MAC,
    frames of 1..1514 bytes both ways byte-exact with block padding, credits through the mod-256
    wrap, full rings, RD_LEN decode, DEVICE_RESET/STOP, the STATUS/SCAN/JOIN/LEAVE mapping.
    bl616_wifi/test: receive filter, start order, drive strength 0 on the SDIO pads, join from the
    stored credentials, link states, control channel, prot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
2026-09-25 MIFA_cst_stripped.tgz: the CST ODB++ reduced for the antenna simulation
    tools/strip_odb_for_cst.py keeps every pour on every layer and net, GND and feed (NetANT1_1)
    traces and pads, vias of GND, the feed and every net with a pour, the outline, stack-up,
    dielectric and solder mask layers, components and netlist; it removes other traces and pads
    (signal and power traces, BGA and component pads), signal vias, silkscreen and paste. Netlist
    feature references are renumbered; files keep their CRLF line ends.
    From MIFA_cst_full.tgz (saved 2026-09-25 06:14): 21 pours byte-identical, L2 unchanged,
    top 2409 -> 630 features, L5 927 -> 0, bottom 1662 -> 539, drills 759 -> 535 (389 GND),
    ODB++ via/track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
2026-09-25 strip_odb_for_cst: keep copper without a net; the antenna element was removed
    The MIFA element is eight net-less pads of the ANT1 footprint, and the first version kept only
    GND and feed-net pads. All copper without a net (footprint copper) is now kept. Everything at
    y >= 53.5 mm (antenna zone above the ground edge) is identical to MIFA_cst_full.tgz: 40
    features, the 8 antenna pads included. Top 2409 -> 732, bottom 1662 -> 555 features; pours
    unchanged, ODB++ via/track net check clean.
2026-09-25 CPL: U5, U8, U10, U14, U15 and D2 turned 180 degrees for JLCPCB's part models
    In JLCPCB's placement preview the pin-1 mark of these parts sat on the corner opposite
    footprint pad 1 (TPS63802 U5/U8/U10, TPS61161 U14/U15), and D2's (DSK24) cathode on the anode
    pad. JLC_ROTATION.csv lists the corrections; the CPL generator applies them (--rot), so a
    regenerated PickPlace_MIFA.csv keeps them. BOM unchanged; 245 placements, 0 mismatches.
2026-09-25 CPL: Q1, Q2, Q4 (SOT-23) turned 180 degrees for JLCPCB's part models
    JLCPCB's pin-1 mark sat about 0.95 mm from pad 3, where a model turned 180 degrees puts pin 1.
2026-09-25 CPL: D3, D5, U16, J4, D4, U6, U7 corrected against JLCPCB's EasyEDA footprints
    JLCPCB rotates the raw EasyEDA footprint by the CPL angle. Overlaying each part's EasyEDA pads on
    ours gives the angle where every pad lands on the pad with the same number: D3, D5, U16 +270 on
    top (confirmed in the preview: U16's pin-1 mark predicted to the pixel, D3 zoomed), J4 +180 on
    the bottom, D4, U6, U7 +270 on the bottom (quarter-turn direction on the bottom to be checked
    in the preview).
2026-09-25 CPL: D4, U6, U7 +90, not +270: JLCPCB mirrors bottom parts after turning them
    The original preview shows D1 (KT-0603R, bottom, 90 degrees) with JLCPCB's anode mark on our
    anode pad. EasyEDA numbers that LED anode = pin 1 (ours: cathode = pin 1), so JLCPCB turns the
    raw EasyEDA footprint by the CPL angle first and mirrors it after. With that rule every one of
    the 46 non-passive parts (ICs, diodes, transistors, crystals, connectors, LEDs) puts each
    EasyEDA pad on our pad of the same number (D1: same function), worst miss 0.04 mm. The +270 for
    the three bottom quarter-turn parts would have placed them 180 degrees wrong.
2026-09-25 Fab package from the 2026-09-25 20:15 export: stitching vias tented
    LEAKCAM_gerber.zip rebuilt: all 14 Altium files byte-identical, outline 61.00 x 65.00 mm.
    The 153 GND stitching vias are now tented on both sides; the only via openings left are vias
    inside pads (U3 BGA balls and SMD pads), which need epoxy filled & capped vias (FAB_NOTES).
    BOM_ASSEMBLY and PickPlace_MIFA unchanged (placements identical, rotation corrections applied,
    0 mismatches against sheets and board; every non-passive part lands pad for pad). Order lists
    for 2 boards.
2026-09-25 JLC_PINMAP.csv: D1 (C2286) pad numbering differs from the EasyEDA footprint, for the placement check
2026-09-28 0.2mm vias
2026-09-29 Firmware: one BL616 image, K230 heartbeat ends the session, RT-Smart wake program
    BL616 (firmware/bl616, replaces bl616_pwrmgr + bl616_wifi):
    - One image. A battery wake decides bare-metal; FreeRTOS starts only for a K230 session.
    - Wi-Fi never starts by default: UART WIFI command, NAK 2 without stored credentials,
    NAK 3 on radio failure. BLE on USB power stores the SSID/password only.
    - WAKE carries reason, unix time, RH, temperature and probe mV; CRC-8 on every frame.
    - The session ends 2 s after the last heartbeat edge on IO2; no SHUTDOWN/HALTED commands.
    Power-off waits 300 ms for RD1/RD2 (1.5 k) to discharge 1V8/3V3.
    - Leak/humidity decisions left to the K230; unused paths and tests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
2026-09-29 Fab package from the 2026-09-29 05:19 export: 0.2 mm vias, C38/C41/C59 placed
    Plated holes are 0.2 mm (917, 0.35 mm pads), 0.6 mm (26) and 0.7 mm (6); no 0.3 mm left.
    BOM_ASSEMBLY / CPL: 248 placements, 56 part numbers, now including the bulk caps C38, C41,
    C59 (C19702); 0 mismatches against sheets and board, all 191 footprinted parts land pad for
    pad with the rotation corrections. Order lists for 2 boards.
    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
2026-09-29 NextPCB order files and AliExpress part-research scripts
    BOM_NEXTPCB.xlsx / CPL_NEXTPCB.csv from the 2026-09-29 05:19 export: 56 lines, 248 placements,
    raw Altium rotations (the JLC_ROTATION corrections apply to JLCPCB's footprints only).
    tools/ali-research: DevTools-driven AliExpress/EU search, item and consolidation scripts,
    sharing tools/jlcpcb-cart's node_modules (ignored).
2026-09-29 Drop the NextPCB order files: NextPCB is not an assembly option
2026-09-29 BL616 event log, link trace, JTAG debug build; battery from the K230 in WAKE
    Debugging (firmware/DEBUG.txt):
    - evlog: the last 32 events (wake, sensors, READY latency, NAKs, Wi-Fi, session and sleep
    lengths, USB, clock, battery) in HBN RAM below the always-on block, CRC-guarded; `evlog` on
    the PR1 USB console prints them. The bare-metal battery wakes are recorded too.
    - One console line per link frame (sent, received, resend, dropped).
    - LEAKCAM_JTAG debug build: JTAG on IO12-IO15 (SDIO pads, Wi-Fi refused) since IO0-IO3 are
    K230_RSTN/ALIVE/PGOOD. OpenOCD 0.12 files for the Lattice HW-USBN-2B and the BL616 (E907).
    Battery: the VBAT/3 divider goes to K230 ADC_1 only, so the agent reads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
2026-09-29 Video with audio (FLV: H.264 + G.711), wake-reason bitmask, first-boot console hold, faster wake
    K230:
    - leakcam_stream: every stream carries the microphone. Push mode sends one FLV per camera
    (flv.c: H.264 from the first IDR + G.711 mu-law 8 kHz mono, written tag by tag into the
    chunked POST); RTSP sessions carry G711U. H.264 only: JPEG channels, HTTP snapshot/MJPEG
    server and H.265 removed. leakcam_audio removed; its mic setup moved into the stream.
    - Sensors always present: the agent sets LEAKCAM_RH/T/PROBE_MV/BAT_MV every time; the wake
    program always sends them. Wake reasons may be combined ("rtc+leak+humid", sent as %2B).
    - Host tests: FLV checked with ffprobe/ffmpeg on a real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
2026-09-30 Leak clip: H.265 + Opus live over Enhanced RTMP to MediaMTX, camera bound to encoder in hardware
    - leakcam_stream publishes each camera to rtmp://<server>:1935/leakcam/cam<N> (rtmp.c: simple
    handshake, connect with fourCcList [hvc1, Opus], createStream, publish): H.265 Main as E-RTMP
    (HEVC decoder configuration record from VPS/SPS/PPS, CodedFramesX), microphone as Opus
    (E-RTMP v2, RFC 7845 ID header). The server's ingest is MediaMTX.
    - Battery: 500 kbit/s, 15 fps, one IDR per clip; Opus 16 kHz mono 24 kbit/s, complexity 3, no DTX
    (quiet leaks must not be dropped). Mic gain PGA 30 dB + ALC analog +24 dB for quiet leaks.
    - VICAP bound to VENC with kd_mpi_sys_bind: no capture threads, n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
2026-09-30 Change net on the KPU: int16 frozen MobileNetV2 feature maps veto light-only imgdiff changes
    leakcam_wake runs leakcam_change.kmodel (MobileNetV2-0.35, ImageNet weights, stride 16,
    int16, 372 KB) on the history view and the current frame where imgdiff saw a change; max
    per-cell cosine distance below 0.44 sleeps without Wi-Fi, a failed net reports. Simulator
    within 0.0014 of TensorFlow. make_embed.py / compile_embed.py build it; NN.txt has the
    design and the retraining plan. Leak-net PoC and the unused imgqual removed.
2026-09-30 NN.txt: field teacher loop (server labels, vetoed frames uploaded, per-camera threshold, distillation)
2026-09-30 created pcblib for all
2026-09-30 Change net updates from the server, vetoed pairs uploaded, daily near-threshold sample
    /v1/check now reports the net in use (kmodel CRC, per-camera thresholds) and each camera's
    state and distance, and sends the history view with every frame imgdiff flagged, so the
    pairs the net called light only reach the server whenever Wi-Fi is up anyway. A light-only
    pair within 0.1 of its threshold is reported on its own at most once a day (sample=1).
    The server answers "nn"/"thr" to offer another net: GET /v1/nn/<CRC>, CRC-checked, stored
    with its thresholds in two slots (nnstore.c), factory kmodel as fallback. refstore's
    durable replace is shared. mock_server.py stores the pairs and offers a kmodel; t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
2026-09-30 add footprints
2026-09-30 Android app LEAKCAM Setup: scan for the board's BLE provisioning service, enter SSID and password, pair and store them
2026-09-30 LEAKCAM Setup: step list with the current step highlighted, and a help box explaining each step, pairing (what the phone shows, no PIN, why USB power) and every failure
2026-09-30 Wi-Fi credential check over BLE: the BL616 joins, gets DHCP and fetches generate_204 before storing
    Commit 0x01 now runs wifi_check.c on the BL616 (USB power, K230 off): scan for the SSID,
    join with use_dhcp=1, resolve and fetch http://connectivitycheck.gstatic.com/generate_204,
    then stop DHCP and leave. A new STATUS characteristic (read/notify) reports joining, address,
    internet, then saved or the failure (not found, wrong password, refused, no address, no DNS,
    no internet, login page, busy); credentials are stored only after the 204 and only if the
    phone is still connected. Commit 0x02 stores unchecked. wifi_link.c gets a radio owner
    (K230 session or check, never both), Wi-Fi bring-up with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
2026-09-30 APP.txt: the setup app's UX, flow, every message and when it shows; two app texts corrected (button name, what USB-only pairing protects)
2026-09-30 Schematics: every component off the Altium vault onto the project libraries
    Symbols link to LEAKCAM.SCHLIB (CON6P to MIFI.SchLib), vault symbol hashes mapped to the
    CMP-* symbols of the same graphics; footprints link to the project PcbLibs (any library,
    all 37 in LEAKCAM.PcbLib), vault GUIDs removed, 782 unused vault alternate footprints
    dropped. Netlists, pins and values unchanged on all 8 sheets.
    Still without a library symbol (untouched): J4 J5, D1, U14 U15, D2 D7 D8, LED1-LED16.
2026-09-30 Schematics: last 25 components onto LEAKCAM.SCHLIB (J4 J5 D1 U14 U15 D2 D7 D8 LED1-LED16, CON6P); no vault link left, netlists unchanged
2026-09-30 mechanical/models: EasyEDA STEP models for the 12 footprints without a 3D model, placement manifest, cached fetcher (lceda.cn mirror)
2026-09-30 mechanical/models: stand-in models for the two parts EasyEDA has none for: FPC 22P 0.5 mm 2.0 mm (XUNPU FPC-05F-22PH20) and MSM381 mic (MSM381ACBA24)
2026-09-30 Drop the per-part libraries: LEAKCAM.PcbLib and LEAKCAM.SCHLIB hold every footprint and symbol; 16 PcbLibs and MIFI.SchLib removed from the project and the repo
2026-09-30 mechanical: base.SLDPRT built by build_base.py; camera part without its lens (it screws in through the base); main board as one multibody part for assemblies
2026-09-30 mechanical: base.SLDPRT and cover.SLDPRT from build_base.py / build_cover.py; USB-C cable plug and LiPo 503450 cell (wires removed) as SolidWorks parts
2026-09-30 mechanical/camera: Arducam B0370 (OV5647, Pi v1.3 format, M12 holder) replaces the 32 x 32 mm wide-angle model; README with the geometry
2026-09-30 mechanical/camera: STEP files stored byte-exact
2026-09-30 Drop mechanical/models: the per-footprint STEP files, EasyEDA cache and fetcher were only for attaching models in Altium; they are embedded in LEAKCAM.PcbLib now
2026-09-30 Revert "Drop mechanical/models: the per-footprint STEP files, EasyEDA cache and fetcher were only for attaching models in Altium; they are embedded in LEAKCAM.PcbLib now"
    This reverts commit 97fd9f9ee6f9deb89c1852697776ca0815e6567f.
2026-09-30 tools/solidworks-mcp: async tools, COM work awaited on the COM thread: a long call no longer blocks the client's other requests (tools/list timed out and the client dropped the server)
2026-09-30 mechanical/enclosure/build_base.py: ABS base from a script - board pocket, antenna-end slot and lip, ribs and USB-C pads, M2 board screw boss, camera pocket centred in the base with four M2 screw pil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
2026-09-30 mechanical/battery: LiPo 503450 3.7 V 1000 mAh cell (34 x 50 x 5 mm), STEP from GrabCAD (UNIT ELECTRONICS, bateria-lipo-3-7v-1000ma-503450-1)
2026-09-30 mechanical/battery: STEP as binary, byte for byte as downloaded
2026-09-30 mechanical/usb: USB Type-C cable plug (STEP from GrabCAD, usb-type-c-cable-plugs-1) for checking the USB-C openings
2026-09-30 mechanical/enclosure: cover from build_cover.py (cell bed, S1-S3/J4 pockets, J4 flex riser and channel, top camera pockets and M12 hole, mic tube and duct); seam at the probe wires' height with half-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
2026-10-01 init assembly
2026-10-01 mechanical/enclosure/assembly.gif: the assembly sequence, each step interference-checked in SolidWorks (cameras, LED strips and clamps, board under the lip, cradle, cells, cover sub-assembly, cover o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
2026-10-01 mechanical/enclosure: printable seam, real probe plugs, build scripts for every part
    - clips.py: the cover's seam lip round the whole perimeter in a rebate in the base (0.2
    clearance, the printer adds ~0.2), 8 snap clips formed from the lip, 4 M2x20 screws from the
    base bottom; the PHR-2 probe plugs' flange pockets, 0.5 bulges and glands (U-slots in the base,
    a saddle tongue per wire in the cover, R0.6 bend round: the wires are the legs)
    - led_strips.py: strip clamps printable on their inner side face, wire channel and notch over
    the strips' mid pads (J3/J6 .. J11/J12), teardrop counterbores
    - build_cover.py: cells touching at the protection boards, flat cradle face (prints face down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
2026-10-11 tools/cr10-marlin: CR-10 Marlin 2.1.2.8, inductive probe bilinear 5x5 leveling, EEPROM
    Melzi ATmega1284P with Optiboot (130048 bytes for firmware). Probe offset X-47 Y-3 Z-1.65 measured
    from the old firmware; Z-min/probe inverted (checked with M119 before homing). Backup of the old
    Marlin 1.1.9 flash included.
2026-10-11 tools/octoprint: start OctoPrint for the CR-10 on COM3 (OrcaSlicer prints through it)
2026-10-11 tools/cr10-marlin: probe Z offset -1.95 (paper test on the hot bed), X bed 300, probing margins centred on the plate
2026-10-11 tools/cr10-marlin: PID autotuned hot end (250 C) and insulated bed (80 C)
2026-10-11 tools/cr10-marlin: probe Z offset -1.75 after the nozzle and heat-break swap
2026-10-12 tools/cr10-marlin: E steps 139.08 for the dual-gear extruder (the example's 95 underextruded by a third)
2026-10-12 tools/cr10-marlin: E steps 140
2026-10-12 tools/cr10-marlin: probe Z offset -1.85 (paper test after a fresh mesh)
2026-10-12 tools/cr10-marlin: nozzle settable to 290 °C, bed to 120 °C; built firmware.hex
2026-10-12 tools/cr10-marlin: nozzle settable to 300 °C (cutoff 320) via a custom thermistor fitted to table 1; boot screen off for flash
2026-10-13 tools/power-bringup: rail checks for the first power-on (off / blank BL616 / flashed), probe-point pictures from the fab ODB++
2026-10-13 tools/power-bringup: BL616 test firmware (rails, UART, I2C, USB detect, leak sense), PR1 wiring, hand-soldered parts and LED chain pictures
2026-10-13 tools/power-bringup: hookup pictures as drawn wiring on the real boards (cells, NTC, LED chains, cameras, PR1 cable, probes)
2026-10-13 tools/power-bringup: one picture per purpose (probe points, top and bottom wiring); drop the duplicate LED, PR1 and bottom pictures and their code
2026-10-14 tools/cr10-marlin: part fan never below 20 % (FAN_MIN_PWM 51) and a 100 ms full-power kickstart
2026-10-14 mechanical/enclosure: SolidWorks parts and fit assembly built from the current form (base, cover, cradle, LED clamps, probe legs)
2026-10-14 tools/cr10-fan-duct: SolidWorks parts and assembly (V6, 40 mm fan, 5015 blower, FANG, shroud, clamp) and the fused print mesh
2026-10-14 mechanical/enclosure: cover with the two knife-edge cuts on the -X side at the seam (Sketch23/25)
2026-10-14 mechanical/enclosure/fit: cover mated to the base (seam faces coincident, lip 0.2 mm from the rebate at the side and the antenna end)
2026-10-14 mechanical/enclosure: base rebuilt (seam screw holes Ø2.2), cradle rebuilt (0.2 mm to the base and cover pockets)
2026-10-14 LFS for STL meshes; ignore __pycache__
2026-10-14 mechanical/enclosure: parametric outer form (form_model.py), LED clamps and probe legs as exports, screw-hole material check; NTC and crimp models to the measured cells; LiPo model from the vendor ST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
2026-10-14 tools/cr10-fan-duct: V6 shroud fused with the FANG part duct, 40 mm fan and 5015 blower mounts
2026-10-14 mechanical/enclosure/fit: every part mated (mate_fit.py): fits at 0.2 mm (cradle, LED clamps and strips, board, cover lip), contacts coincident, screws concentric and seated, cells/cameras/plugs/wire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
2026-10-14 mechanical/enclosure: cover user cuts for the two knife edges on the -X side at the seam (fit 10-14 Sketch23/25)
2026-10-14 mechanical/enclosure: 0.2 mm everywhere the cradle meets the base and cover (was 0.05), seam screw clearance holes Ø2.2 (was Ø2.1); the cover's cell pocket unchanged
2026-10-14 mechanical/enclosure/fit: mate_fit.py remakes every mate of the fit assembly after a rebuild (contact coincident, clearance fits as 0.2 mm distance mates, screws concentric and seated), and reports a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
2026-10-14 mate_fit.py: 0.01 mm move tolerance, concentric mates for round fits (camera screws, lenses, plugs), ONLY = [...] redoes just those parts
2026-10-14 mate_fit.py: a screw takes the pilot it overlaps (the cameras' pilots share an axis), its head a seat near it
2026-10-14 mate_fit.py: parts with no fit faces (glued cells, cameras, lenses, plugs, wires) held by origin-plane mates at their actual offsets
2026-10-15 orca-patch: modifier volumes placed like support boxes (slicer ignored them); POST /app/quit
    An uncentred mesh under the inverse instance matrix was listed as a modifier but
    never changed a region: the cover's seam band left fuzzy skin on. Now centred and
    offset as handle_add_support_volume does; checked with a 7 mm/s outer wall cube
    and the band (in-band walls 1.23 mm moves, plain; outside 0.44, fuzzy).
    POST /app/quit closes OrcaSlicer without dialogs, so installs no longer kill it
    (a killed Orca asks to restore its project at the next start).
2026-10-15 mechanical/enclosure/print: fuzzy-skin-off band for the cover print (the base/cover split faces extruded 1.2 mm both ways, lip included), in plate coordinates of the cover's print orientation
2026-10-15 mechanical/enclosure: 0.2 mm off the cover on every sloped/stepped face of the base/cover split (43 faces, 463 mm3); the cover seats on the flat seam only
2026-10-15 mechanical/enclosure: back out the seam clearance slab cut (7624e48): it left hair-thin slivers and tiny faces that broke the cover build; the cover piece is the clean one again
2026-10-15 enclosure: fit the boards as made (main 36.9 x 64.9, LED 37.2 x 5.6)
    Main board 0.4 wider than designed: the base's board pocket X +-18.65 (0.2 each
    side), with the USB-C notches, ribs and screw boss; the seam ring stays at 18.45
    so the cover's lip and the cradle are unchanged. LED strip 0.6 wider: seats
    37.6 x 6.0, clamp bosses tried 0.3 further out; the strip frames stay pinned.
2026-10-15 enclosure: the base's board-edge blocks (supports, screw block, band opening, +X side fill) at the 18.65 pocket wall
    At 18.45 the wider pocket cut a 0.4 mm loose sliver off a support block.
2026-10-15 enclosure: drop loose specks after each body cut; cover print files in model coordinates
    A probe leg channel past the cover's lip left a zero-volume speck (2 bodies, the
    shell step stopped). print/: the fuzzy skin shell (outer form -1.0..+0.5 mm) and
    the seam band (no fuzz), and orient.py, which turns the cover and both into any
    print orientation in plate coordinates.
2026-10-15 form_model: LED clamps exported with their placement baked in
    A placed shape is written as a one-part STEP assembly, which SolidWorks imports
    as an assembly; the clamps now import as parts.
2026-10-16 enclosure: base, cover, cradle and LED clamps rebuilt for the boards as made
    Base board pocket +-18.65, LED seats 37.6 x 6.0, wider clamps; the fit assembly
    is re-mated next.
2026-10-16 enclosure: base and cover with the corrected LED holes; fit assembly re-mated
    Board 0.2 to the board as made, cradle and LED clamps 0.2, LED strips 0.19-0.21 in
    their holes; parts without a clearance fit (cells, cameras, lenses, plugs, wires,
    legs, screws) on their origin planes, the tilted clamp screws fixed. Open: the
    sloped cover/base seam (0).
2026-10-16 mate_fit: read faces with typed calls; no face reading for parts without a clearance fit
    Late-bound calls looked every name up again: ~200 ms a face, 45 min a run. Typed
    IFace2/IBody2 calls and IFace2.Normal for planes: ~40 ms. Cells, NTC, cameras,
    lenses, USB plugs, wires and probe legs need no clearance mate (user): straight
    to their origin planes.
2026-10-16 LED holes on the designed strip positions, 0.2 round the LED; mate_fit finds split screw threads
    The holes counted from the real strip's end (37.2) moved 0.1 and clipped the LEDs;
    they count from the designed 37.0 again, and are the LED body + 0.2 each side
    (3.9, was 3.6: printed too tight). The screw's thread is several cylinder faces:
    any of them in the pilot matches (the first one alone missed every pilot).
2026-10-16 mate_fit: screws held by origin planes (no clearance fit), tilted ones fixed; old mates deleted in one go
    The screw match took the head's socket faces for the shank and found no pilot;
    screws need no clearance mate (user). Deleting the mates one by one took 1.2 s each.
2026-10-16 LED strips as their own 2-layer panel, cut out of the main board's fab outputs
    The four strips use the outer layers only; tools/led-panel/make_led_panel.py copies
    their objects into 5.6 x 37.2 cells (the size of the boards as made, V-cuts 0.67 /
    0.45 mm from copper), 4 side by side with 5 mm rails (22.4 x 47.2), V-cut lines in
    their own file, 3 fiducials, and the 16 LEDs' BOM and CPL with the JLC rotations.
2026-10-16 power-bringup: one LED wiring picture, made to print in black and white
    led_wiring.png: the strips' wires numbered in soldering order, the white chain
    solid and the IR chain dashed, each wire in its own lane (none crossing), with the
    wire list and the polarity check under it. hookup_top.png no longer draws the
    LED wires (they overlapped there).
2026-10-16 LED wiring: IR pin 2 is + (the sheet had it reversed)
    The JNJ footprint names its anode pad 1 and its cathode pad 3, against the
    datasheet; the bring-up page read pad 1 as the datasheet's cathode and put + on
    pin 1, so every IR strip wired from it lit reversed (measured 2026-10-16). Fixed
    in the README and led_wiring.png; strips already wired that way: swap the two
    wires at J2. Rev 2 of the strips: +/- silkscreen and a square pin 1 at the wire
    pads, pads numbered like the datasheet.
2026-10-16 LED wiring picture as built: IR J2 + > D > C > B > A > J2 -
    The strips were wired from the first sheet and the two wires at J2 swapped;
    the picture and the README now show that wiring. No silkscreen change for the
    strips (the placement is right, user).
2026-10-16 power-bringup: LED strip test record (white chain lights from 19.6 V, IR from 10.0 V)
2026-10-17 mechanical/enclosure: drop the old assembly animation (not used, the fit is checked in fit.SLDASM)
2026-10-17 power-bringup: battery-only phase (cell on JB1, no USB): BAT, VBAT, 3V3_SLEEP up, the K230 rails off
    testpoints.json, power_check.py battery and a column in the README limits; the
    points are the same numbers as in top.png / top_power_zoom.png.
2026-10-17 power-bringup: battery-only test record (3V3_SLEEP 3.298 V, BAT and VBAT ~3.9 V: pass)
2026-10-17 power-bringup: the pictures used in the tests in the test records; charging test record (readings pending)
    hookup_battery.png (the cells and the NTC, zoomed from hookup_top.png), battery_only.png
    and charging.png (each test's probe points with the required readings), all drawn by
    render_testpoints.py.
2026-10-17 bugs/bug-001: U1 is BQ24072T, battery never charges (TS has no internal bias); rev 2 fix and rev 1 workarounds
2026-10-17 power-bringup: charging test failed (bug-001); PR1 debug-cable zoom and the USB-C CC resistor; flash with the x86 flasher in the build container
2026-10-17 power-bringup: K230 rails pass and the K230 ROM enumerates (29f1:0230); bug-002: rails on back-feed VUSB, USB-C hosts do not power the board
2026-10-17 power-bringup: debug serial on USBC2 works (CH340, K230 ROM output at 115200)
2026-10-17 power-bringup: k230_hello, bare-metal status line per second on the K230 debug UART from SRAM over USB (no NAND); K230 runs at 800 MHz from the ROM
2026-10-17 K230 NAND boot: plain SPL (the ROM rejects the EVB swap_fn with exit code 13); SPL boots, DDR trains at 2667; BL616 pt_boot1 drives BOOT1 low by default; boot strap sheets
2026-10-17 K230: no PMU (bug-003): BOARD_NOT_SUPPORT_HW_RTC, software RTC, 64-pad pin table; bugs/v2.txt with the rev 2 changes
